ikrasmus/Bestaboard/README.md

"# Bestaboard" 

<h1>Heading</h1>

# Project Title
## Features
- Feature 1
- Feature 2
