ikrasmus/Bestaboard/BOM/BOM_PCB_Components.pdf

Reference | Qty | Value | DNP | Exclude from BOM | Exclude from Board | Footprint | Datasheet | Purchase Link | Cost Per | Cost Total
C1,C2,C3,C4,C5,C6,C7,C8 | 8 | 0.1uF | | | | Capacitor_SMD:C_0603_1608Metric_Pad1.08x0.95mm_HandSolder https://yageogroup.com/content/datasheet/asset/file/KEM_C1002_X7R_SMD https://www.digikey.com/en/products/detail/kemet/C0603C104K5RACTU/1465594 0.06 | | | | 0.48
C9,C10 | 2 | 1uF | | | | Capacitor_SMD:C_0603_1608Metric_Pad1.08x0.95mm_HandSolder https://yageogroup.com/content/datasheet/asset/file/KEM_C1002_X7R_SMD https://www.digikey.com/en/products/detail/kemet/C0603C105K4RACTU/2199788 0.05 | | | | 0.1
H1,H2,H3,H4 | 4 | MountingHole | | Excluded from BOM | | MountingHole:MountingHole_3.2mm_M3_ISO14580~ | | | 0 | 0
J1,J2 | 2 | S5B-XH-A | | | | Connector_JST:JST_XH_S5B-XH-A_1x05_P2.50mm_Horizontal https://www.jst-mfg.com/product/pdf/eng/eXH.pdf https://www.digikey.com/en/products/detail/jst-sales-america-inc/S5B-XH-A/1651040 0.22 | | | | 0.44
J3 | 1 | PPTC051LGBN-RC | | | | Connector_PinHeader_2.54mm:PinHeader_1x05_P2.54mm_Horizontal https://mm.digikey.com/Volume0/opasdata/d220001/medias/docus/937/Female_Headers.100_DS.pdf https://www.digikey.com/en/products/detail/sullins-connector-solutions/PPTC051LGBN-RC/775899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 0.54 | | | | 0.54
J4,J10 | 2 | XHP-5 | | Excluded from BOM | Excluded from board | | https://www.jst-mfg.com/product/pdf/eng/eXH.pdf https://www.digikey.com/en/products/detail/jst-sales-america-inc/XHP-5/1125486 0 | | | 0
J5 | 1 | PPTC061LGBN-RC | | | | Connector_PinHeader_2.54mm:PinHeader_1x06_P2.54mm_Horizontal https://mm.digikey.com/Volume0/opasdata/d220001/medias/docus/937/Female_Headers.100_DS.pdf https://www.digikey.com/en/products/detail/sullins-connector-solutions/PPTC061LGBN-RC/775900 0.54 | | | | 0.54
J6 | 1 | PRPC006SGAN-M71RC | | | | Connector_PinHeader_2.54mm:PinHeader_1x06_P2.54mm_Vertical https://mm.digikey.com/Volume0/opasdata/d220001/medias/docus/2610/x%20RxCxxxSxxN-M71RC_%2011637-B.pdf https://www.digikey.com/en/products/detail/sullins-connector-solutions/PRPC006SGAN-M71RC/2775448 0.4 | | | | 0.4
J7,J8 | 2 | S3B-XH-A | | | | Connector_JST:JST_XH_S3B-XH-A_1x03_P2.50mm_Horizontal https://www.jst-mfg.com/product/pdf/eng/eXH.pdf https://www.digikey.com/en/products/detail/jst-sales-america-inc/S3B-XH-A/1651048 0.15 | | | | 0.3
J9 | 1 | PRPC005SGAN-M71RC | | | | Connector_PinHeader_2.54mm:PinHeader_1x05_P2.54mm_Vertical https://mm.digikey.com/Volume0/opasdata/d220001/medias/docus/2610/x%20RxCxxxSxxN-M71RC_%2011637-B.pdf https://www.digikey.com/en/products/detail/sullins-connector-solutions/PRPC005SGAN-M71RC/2775449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 0.38 | | | | 0.38
J11,J12 | 2 | XHP-3 | | | Excluded from board | | https://www.jst-mfg.com/product/pdf/eng/eXH.pdf https://www.digikey.com/en/products/detail/jst-sales-america-inc/XHP-3/1651017 0.07 | | | 0.14
M1,M2 | 2 | 28BYJ-48 | | | Excluded from board | | http://www.infineon.com/dgdl/Application-Note-TLE8110EE_driving_UniPolarStepperMotor_V1.1.pdf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 https://www.amazon.com/s?k=28byj-48&crid=374TO9H7W8172&sprefix=28byj-48%2Caps%2C175&ref=nb_sb_noss_1 2.92 | | | 5.84
U1 | 1 | CD74HCT164E | | | | Package_DIP:DIP-14_W7.62mm_LongPads | https://www.ti.com/lit/ds/symlink/cd74hct164.pdf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 https://www.digikey.com/en/products/detail/texas-instruments/CD74HCT164E/38350 0.53 | | | 0.53
U2,U3 | 2 | CD4042BE | | | | Package_DIP:DIP-16_W7.62mm_LongPads | https://www.ti.com/lit/ds/symlink/cd4042b.pdf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 https://www.digikey.com/en/products/detail/texas-instruments/CD4042BE/67289 0.49 | | | 0.98
U4 | 1 | SN74HC00N | | | | Package_DIP:DIP-14_W7.62mm_LongPads | https://www.ti.com/lit/ds/symlink/sn74hc00.pdf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 https://www.digikey.com/en/products/detail/texas-instruments/SN74HC00N/277209 0.51 | | | 0.51
U5 | 1 | CD4081BE | | | | Package_DIP:DIP-14_W7.62mm_LongPads | https://www.ti.com/general/docs/suppproductinfo.tsp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 https://www.digikey.com/en/products/detail/texas-instruments/CD4081BE/67323 0.73 | | | 0.73
U6,U7 | 2 | DRV5032FALPGM | | | Excluded from board | Package_TO_SOT_THT:TO-92_Inline | https://www.ti.com/lit/ds/symlink/drv5032.pdf https://www.digikey.com/en/products/detail/texas-instruments/DRV5032FALPGM/12165125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 0.25 | | | 0.5
U8,U9 | 2 | ULN2003A | | Exclude from BOM | | Package_DIP:DIP-16_W7.62mm_LongPads | https://www.ti.com/lit/ds/symlink/uln2003a.pdf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 0 | | | 0
U10 | 1 | TC74HC04APF | | | | Package_DIP:DIP-14_W7.62mm_LongPads | https://mm.digikey.com/Volume0/opasdata/d220001/medias/docus/889/TC74HC04.pdf https://www.digikey.com/en/products/detail/toshiba-semiconductor-and-storage/TC74HC04APF/870457 0.18 | | | 0.18
| | | | | | | | | Total: | 12.59
