ikrasmus/Bestaboard/BOM/BOM_Print_Material.pdf

Plate | Material 1 (g) | Material 2 (g) | Time (m)
Drum - Main | 32.3 | 0 | 64
Drum - End | 10.3 | 0 | 30
Flips - 1 | 14.3 | 3.4 | 54
Flips - 2 | 14.3 | 3.4 | 55
Flips - 3 | 15.3 | 2.4 | 51
Frame - Main | 41.43 | 0 | 89
Frame - Holder (0.5) | 1.7 | 0 | 8
Frame - Connector (0.5) | 0.9 | 0 | 6
PCB - Spacer (0.5) | 0.4 | 0 | 4.5
PCB - Connector (0.5) | 0.6 | 0 | 5
Total | 131.53 | 9.2 | 366.5
Total Material: | 140.73
Bulk Material Cost (1kg): | 12.99
Total Cost: | $1.83
