ikrasmus/Bestaboard/Prints/Individual/Flips/Assembled - Asterisk - Char_Prev_Top-1.STL

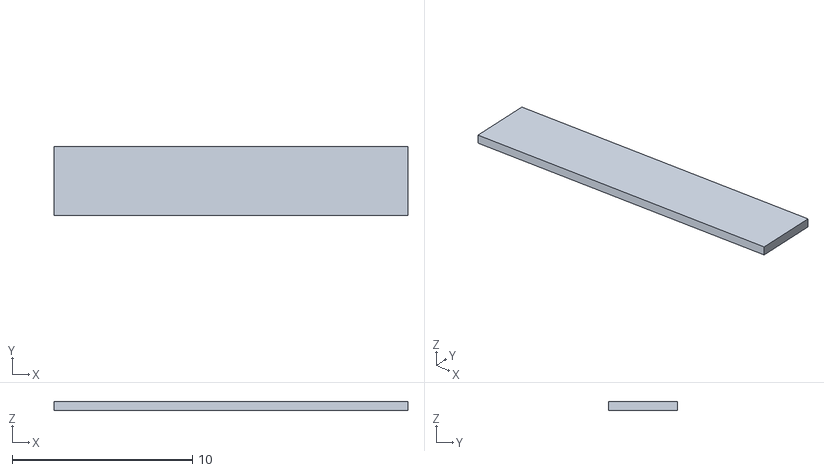
[picture p4: CAD file, 2026-02-08]
Prints/Individual/Flips/Assembled - Asterisk - Char_Prev_Top-1.STL
19.6 x 3.85 x 0.5
