ikrasmus/Bestaboard/Prints/Individual/Tools/Tool - Drum_Assembly.STL

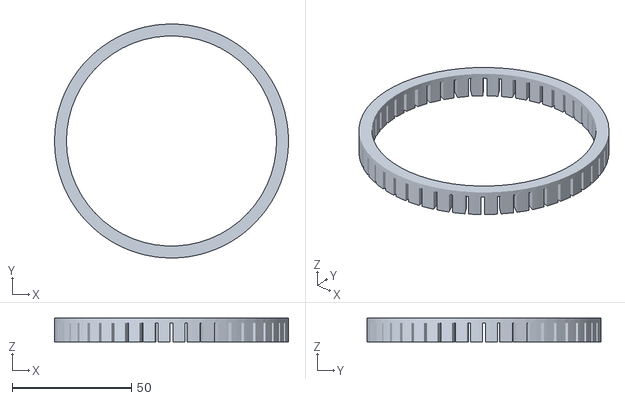
[picture p5: CAD file, 2026-04-19]
Prints/Individual/Tools/Tool - Drum_Assembly.STL
98.0 x 98.0 x 10.0
