ikrasmus/Bestaboard/Prints/Individual/Flips/Assembled - 5 - Body_Bottom-1.STL

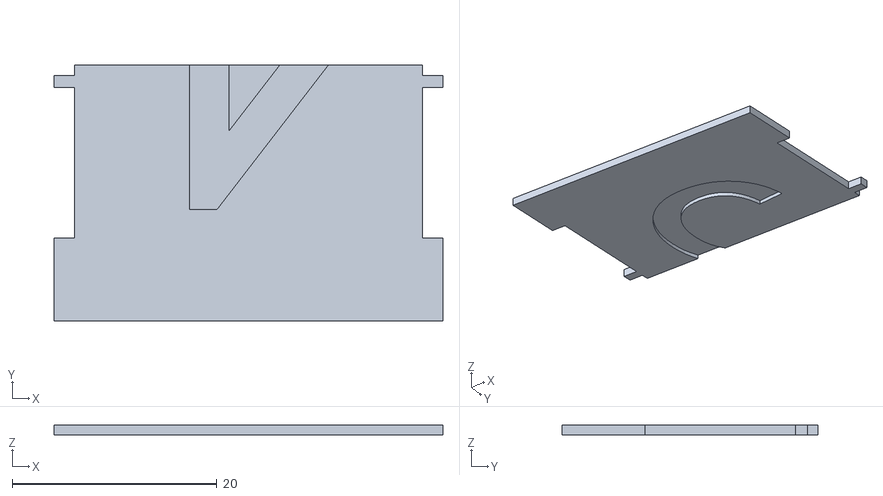
[picture p6: CAD file, 2026-02-08]
Prints/Individual/Flips/Assembled - 5 - Body_Bottom-1.STL
38.0 x 25.0 x 1.00
