ikrasmus/Bestaboard/Prints/Individual/Flips/Assembled - Question - Body_Bottom-1.STL

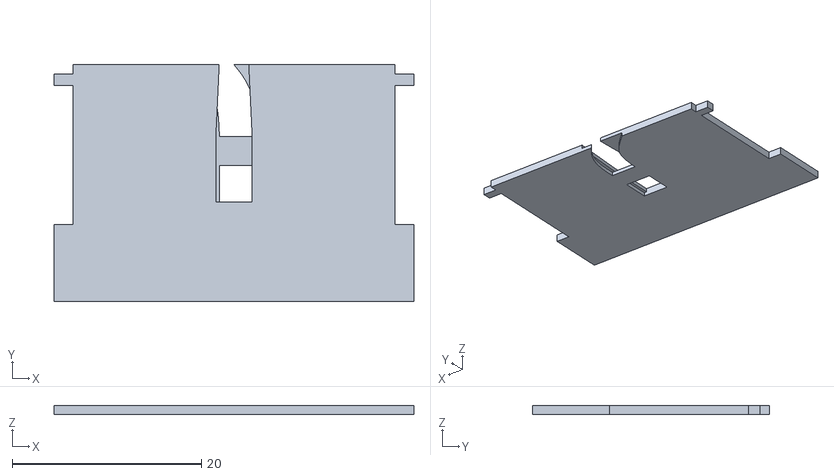
[picture p7: CAD file, 2026-02-08]
Prints/Individual/Flips/Assembled - Question - Body_Bottom-1.STL
38.0 x 25.0 x 1
