ikrasmus/Bestaboard/Prints/Individual/Flips/Assembled - Asterisk - Char_Top-1.STL

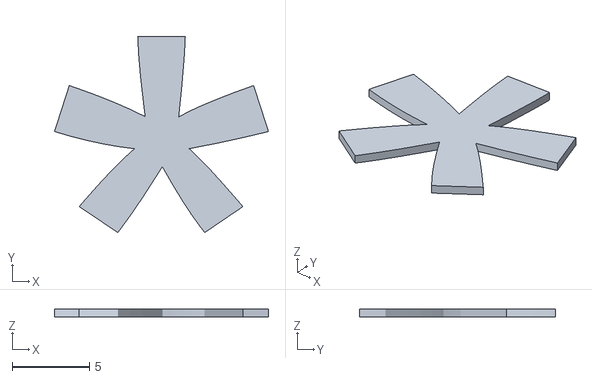
[picture p8: CAD file, 2026-02-08]
Prints/Individual/Flips/Assembled - Asterisk - Char_Top-1.STL
13.8 x 12.7 x 0.5
