ikrasmus/Bestaboard/Prints/Individual/Frame & Drum/Drum - Main.STL

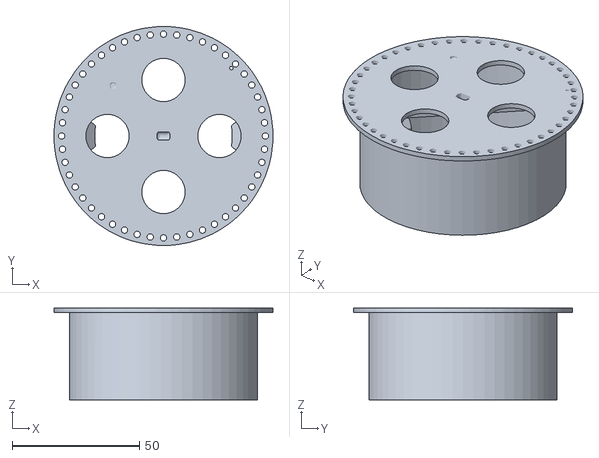
[picture p9: CAD file, 2026-04-25]
Prints/Individual/Frame & Drum/Drum - Main.STL
86.0 x 86.0 x 36.0
