ikrasmus/Bestaboard/Solidworks/Frame & Drum/Frame - Main.SLDPRT

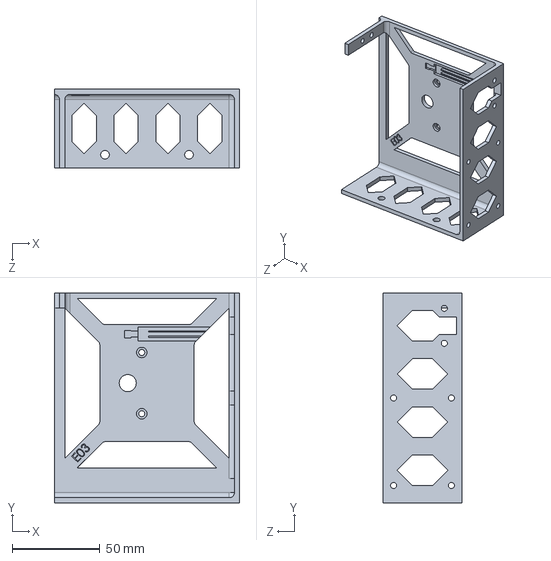
[picture p10: CAD file, 2026-04-25]
Solidworks/Frame & Drum/Frame - Main.SLDPRT
106.0 x 120.0 x 45.0 mm
