ikrasmus/Bestaboard/Prints/Individual/Flips/Assembled - Question - Char_Top-1.STL

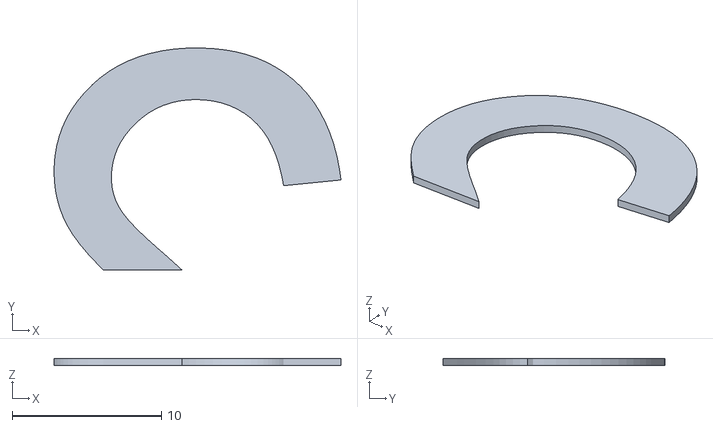
[picture p11: CAD file, 2026-02-08]
Prints/Individual/Flips/Assembled - Question - Char_Top-1.STL
19.2 x 14.9 x 0.5
