ikrasmus/Bestaboard/Prints/Individual/Flips/Assembled - Question - Char_Next_Bottom-1.STL

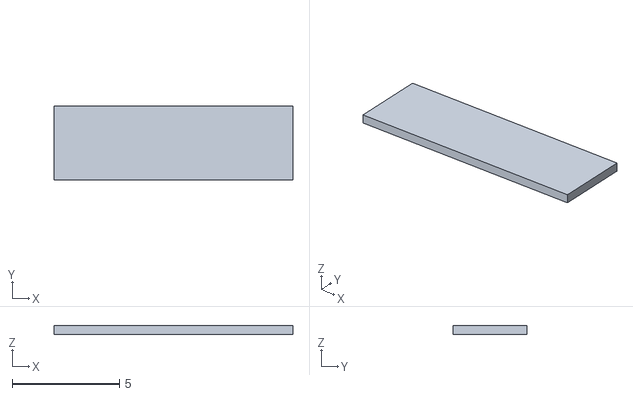
[picture p12: CAD file, 2026-02-08]
Prints/Individual/Flips/Assembled - Question - Char_Next_Bottom-1.STL
11.2 x 3.46 x 0.4
