ikrasmus/Bestaboard/Prints/Individual/Flips/Assembled - + - Char_Bottom-1.STL

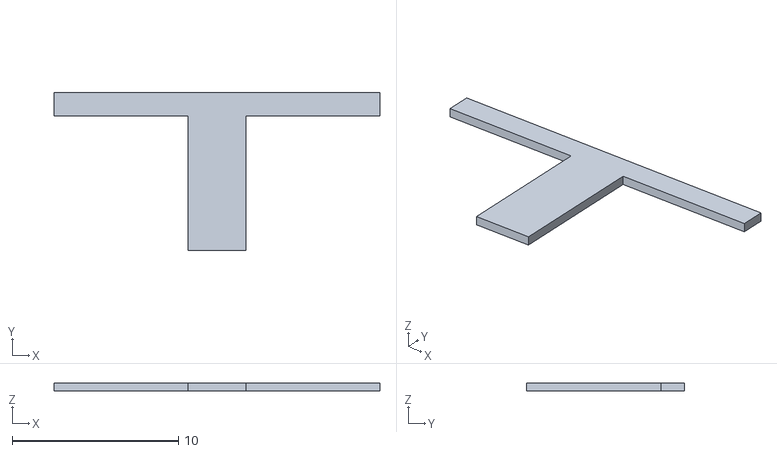
[picture p13: CAD file, 2026-02-08]
Prints/Individual/Flips/Assembled - + - Char_Bottom-1.STL
19.6 x 9.50 x 0.5
