ikrasmus/Bestaboard/Prints/Individual/Flips/Assembled - , - Prev_Extrude-1.STL

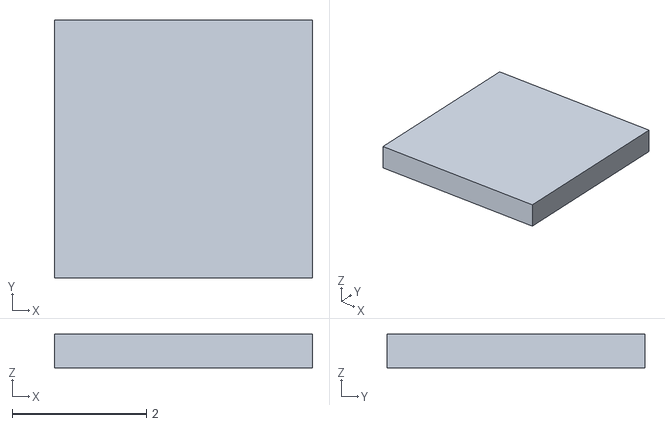
[picture p14: CAD file, 2026-02-08]
Prints/Individual/Flips/Assembled - , - Prev_Extrude-1.STL
3.85 x 3.85 x 0.5
