ikrasmus/Bestaboard/Prints/Individual/Flips/Assembled - Colon - Char_Prev_Top-1.STL

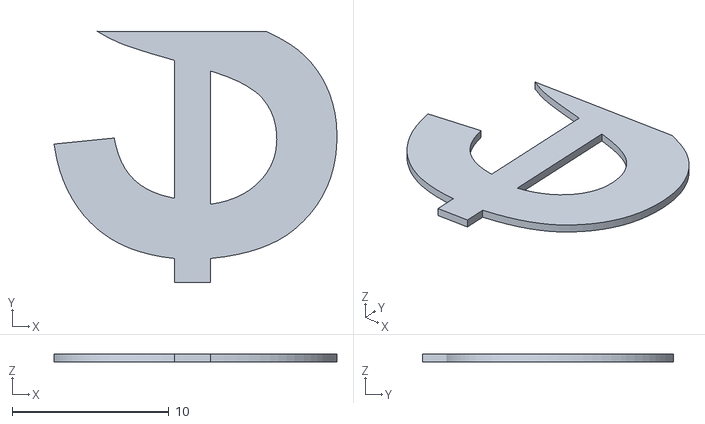
[picture p15: CAD file, 2026-02-08]
Prints/Individual/Flips/Assembled - Colon - Char_Prev_Top-1.STL
18.1 x 16.0 x 0.5
