ikrasmus/Bestaboard/Prints/Individual/Flips/Assembled - + - Char_Top-1.STL

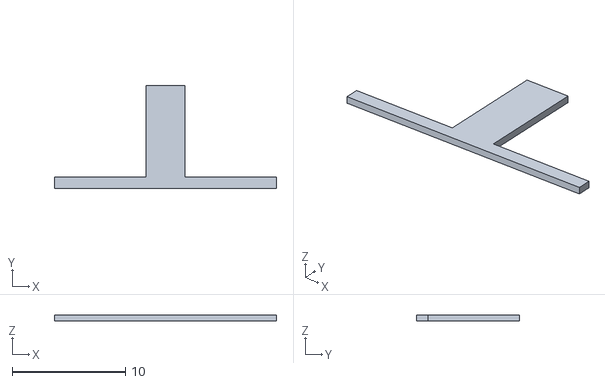
[picture p16: CAD file, 2026-02-08]
Prints/Individual/Flips/Assembled - + - Char_Top-1.STL
19.6 x 9.12 x 0.5
