ikrasmus/Bestaboard/Prints/Individual/Flips/Assembled - Home - Char_Next_Bottom-1.STL

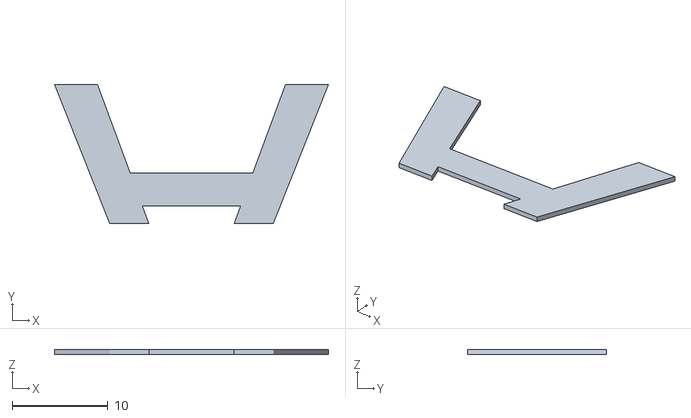
[picture p17: CAD file, 2026-02-08]
Prints/Individual/Flips/Assembled - Home - Char_Next_Bottom-1.STL
28.6 x 14.5 x 0.5
