ikrasmus/Bestaboard/Prints/Individual/Flips/Assembled - , - Front_Extrude-1.STL

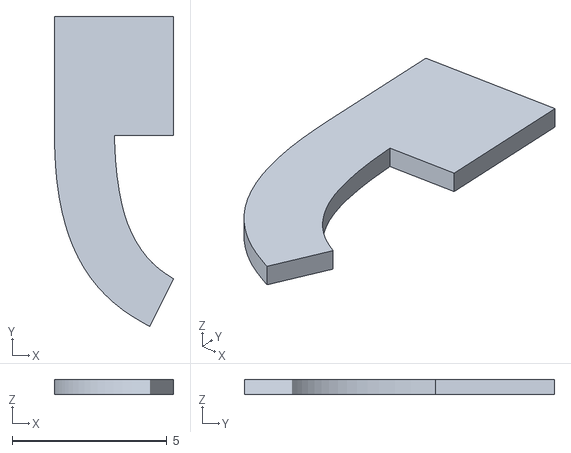
[picture p18: CAD file, 2026-02-08]
Prints/Individual/Flips/Assembled - , - Front_Extrude-1.STL
3.85 x 10.0 x 0.5
