ikrasmus/Bestaboard/Prints/Individual/Flips/Assembled - Asterisk - Char_Next_Bottom-1.STL

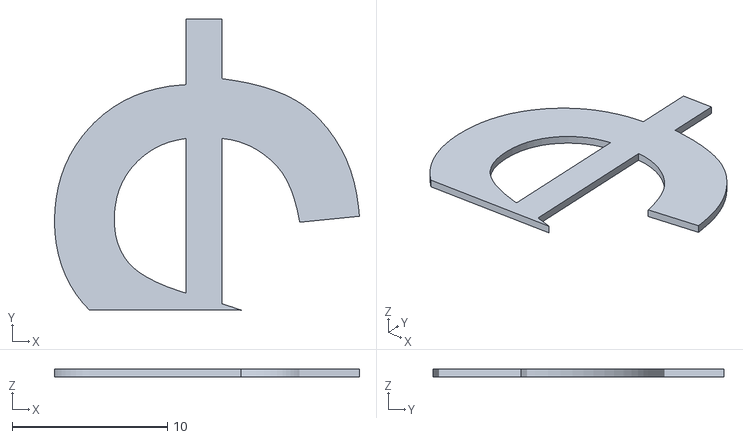
[picture p19: CAD file, 2026-02-08]
Prints/Individual/Flips/Assembled - Asterisk - Char_Next_Bottom-1.STL
19.6 x 18.7 x 0.5
