ikrasmus/Bestaboard/Prints/Individual/Flips/Assembled - , - Char_Next_Bottom-1.STL

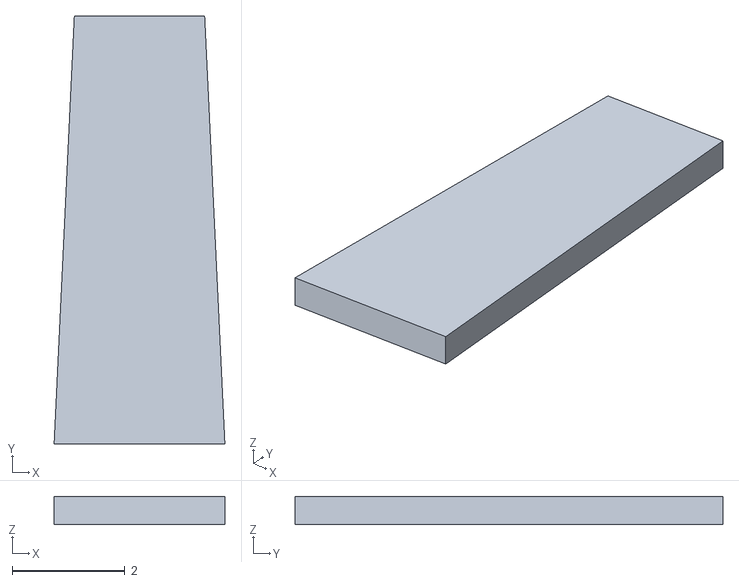
[picture p20: CAD file, 2026-02-08]
Prints/Individual/Flips/Assembled - , - Char_Next_Bottom-1.STL
3.02 x 7.58 x 0.5
