ikrasmus/Bestaboard/Prints/Individual/Flips/Assembled - Question - Char_Bottom_1-1.STL

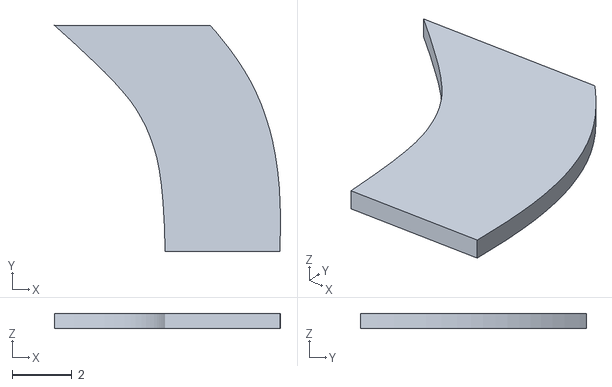
[picture p21: CAD file, 2026-02-08]
Prints/Individual/Flips/Assembled - Question - Char_Bottom_1-1.STL
7.57 x 7.58 x 0.5
