ikrasmus/Bestaboard/Prints/Individual/Flips/Assembled - Question - Char_Prev_Top-1.STL

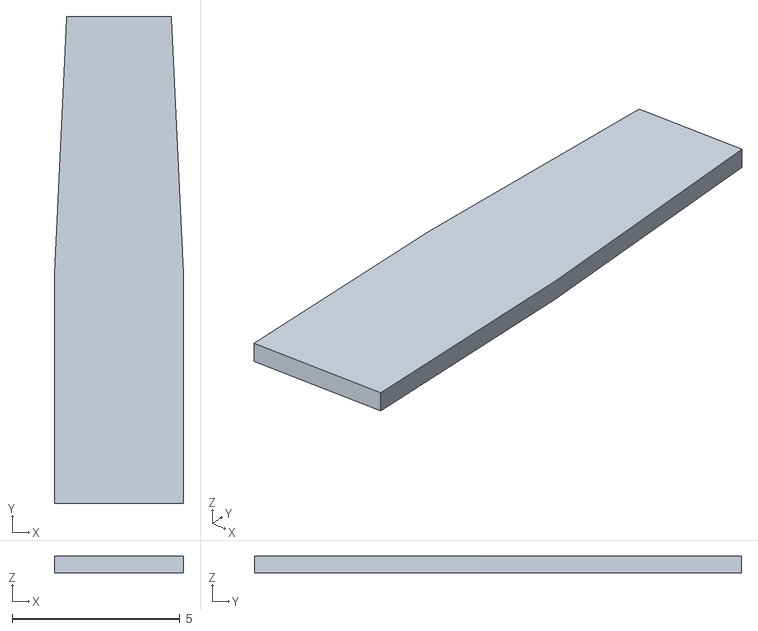
[picture p22: CAD file, 2026-02-08]
Prints/Individual/Flips/Assembled - Question - Char_Prev_Top-1.STL
3.85 x 14.5 x 0.5
