ikrasmus/Bestaboard/Prints/Individual/Flips/Assembled - 7 - Char_Top-2.STL

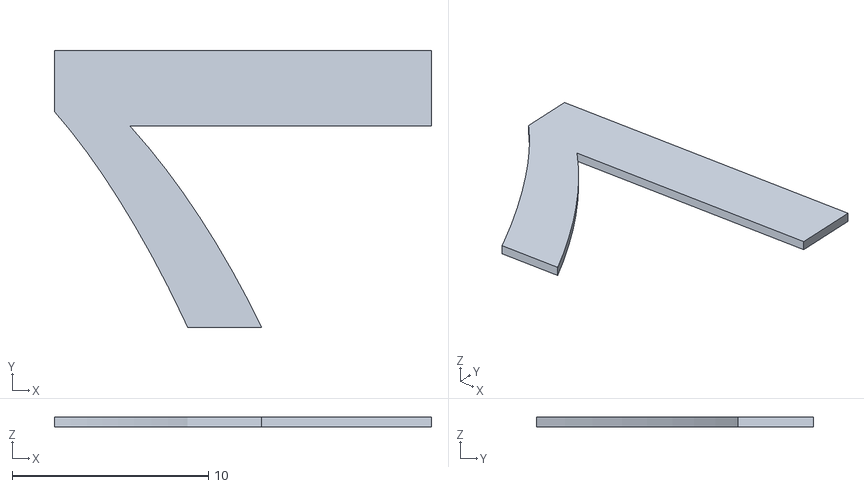
[picture p23: CAD file, 2026-02-08]
Prints/Individual/Flips/Assembled - 7 - Char_Top-2.STL
19.2 x 14.1 x 0.5
