ikrasmus/Bestaboard/Prints/Individual/Flips/Assembled - 9 - Char_Prev_Top-1.STL

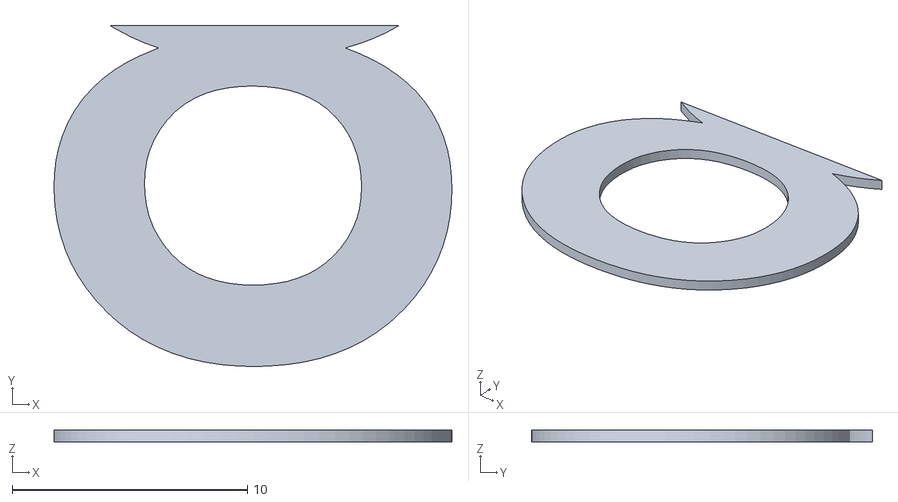
[picture p24: CAD file, 2026-01-27]
Prints/Individual/Flips/Assembled - 9 - Char_Prev_Top-1.STL
16.9 x 14.5 x 0.5
