ikrasmus/Bestaboard/Prints/Individual/Flips/Assembled - 5 - Char_Prev_Top-1.STL

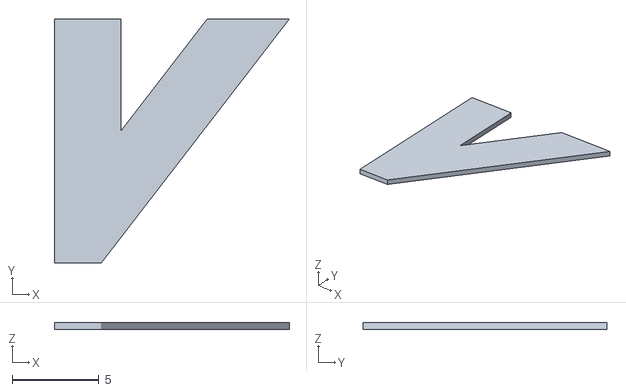
[picture p25: CAD file, 2026-01-27]
Prints/Individual/Flips/Assembled - 5 - Char_Prev_Top-1.STL
13.6 x 14.1 x 0.4
