ikrasmus/Bestaboard/Prints/Individual/Flips/Assembled - 7 - Char_Bottom-1.STL

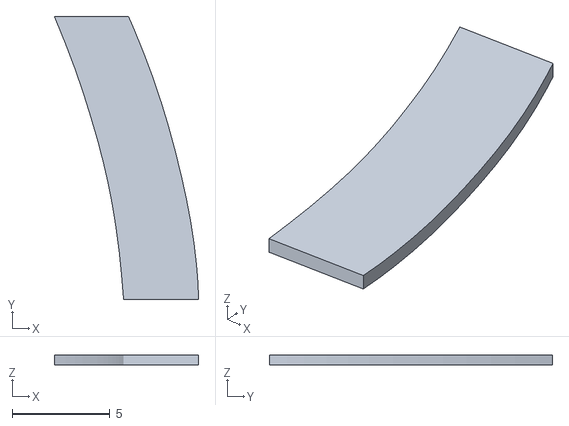
[picture p26: CAD file, 2026-01-27]
Prints/Individual/Flips/Assembled - 7 - Char_Bottom-1.STL
7.39 x 14.5 x 0.5
