ikrasmus/Bestaboard/Prints/Individual/Flips/Assembled - 9 - Char_Bottom-1.STL

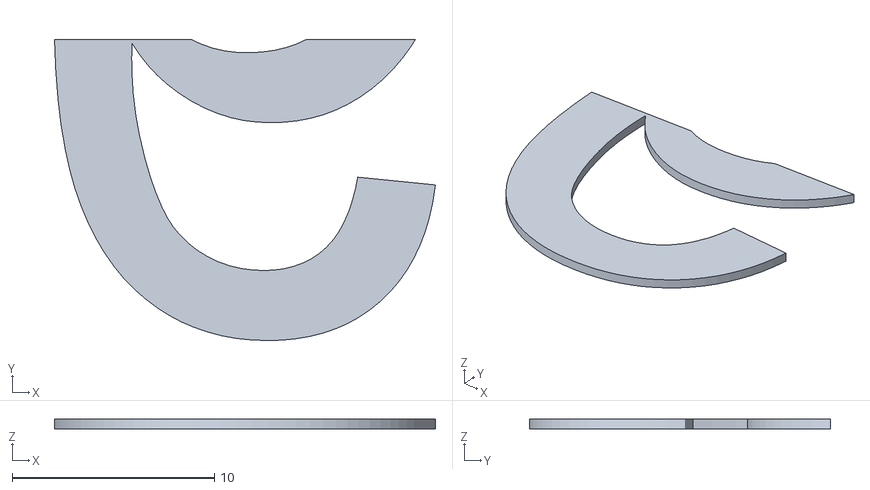
[picture p27: CAD file, 2026-01-27]
Prints/Individual/Flips/Assembled - 9 - Char_Bottom-1.STL
18.8 x 14.9 x 0.5
