ikrasmus/Bestaboard/Prints/Individual/Flips/Assembled - 1 - Char_Bottom-1.STL

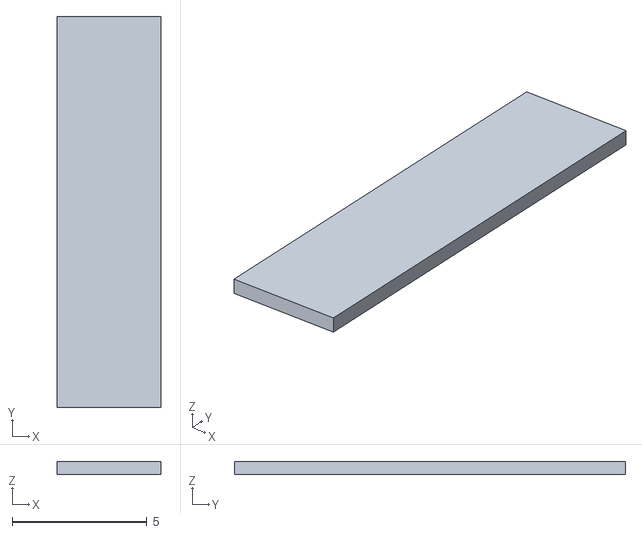
[picture p28: CAD file, 2026-01-27]
Prints/Individual/Flips/Assembled - 1 - Char_Bottom-1.STL
3.85 x 14.5 x 0.5
