ikrasmus/Bestaboard/Prints/Individual/Flips/Assembled - 1 - Char_Next_Bottom-1.STL

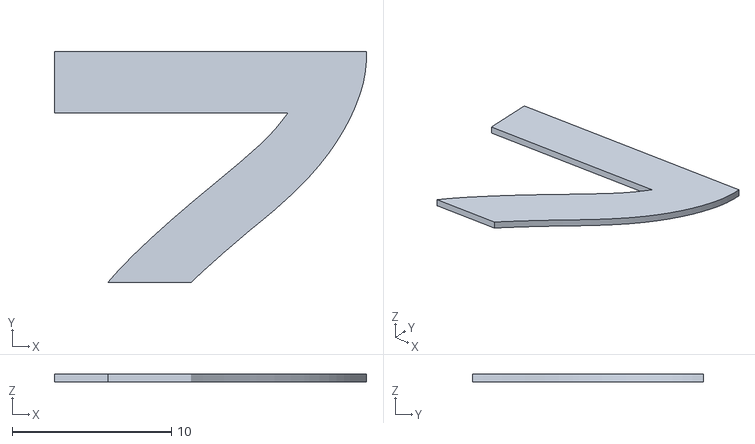
[picture p29: CAD file, 2026-01-27]
Prints/Individual/Flips/Assembled - 1 - Char_Next_Bottom-1.STL
19.6 x 14.5 x 0.5
