ikrasmus/Bestaboard/Prints/Individual/Flips/Assembled - 5 - Char_Bottom-1.STL

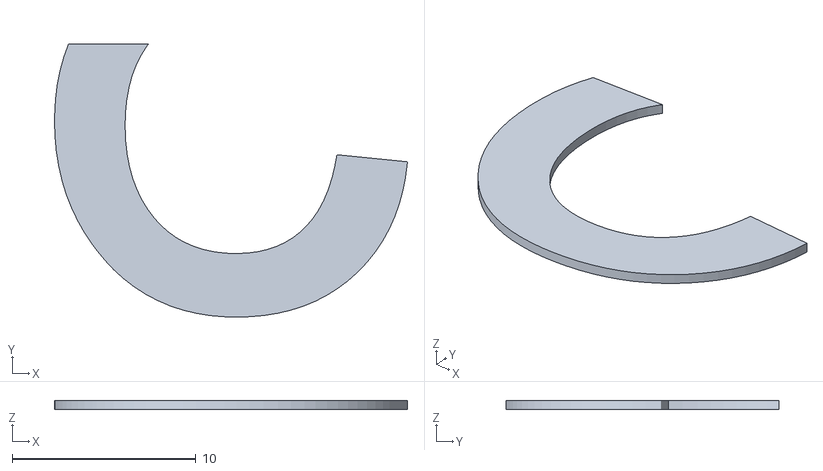
[picture p30: CAD file, 2026-01-27]
Prints/Individual/Flips/Assembled - 5 - Char_Bottom-1.STL
19.2 x 14.9 x 0.5
