ikrasmus/Bestaboard/Prints/Individual/Flips/Assembled - Z - Char_Top-1.STL

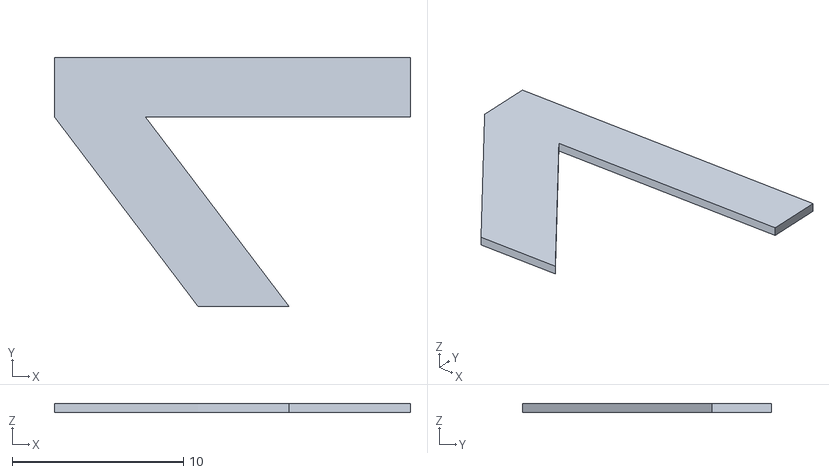
[picture p31: CAD file, 2026-01-27]
Prints/Individual/Flips/Assembled - Z - Char_Top-1.STL
20.8 x 14.5 x 0.5
