ikrasmus/Bestaboard/Prints/Individual/Flips/Assembled - 3 - Body_Bottom-1.STL

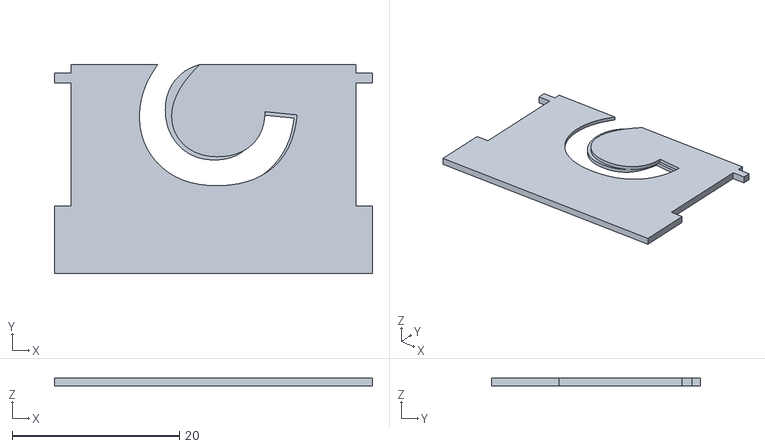
[picture p33: CAD file, 2026-01-27]
Prints/Individual/Flips/Assembled - 3 - Body_Bottom-1.STL
38.0 x 25.0 x 1.00
