ikrasmus/Bestaboard/Prints/Individual/Flips/Assembled - 9 - Body_Bottom_2-1.STL

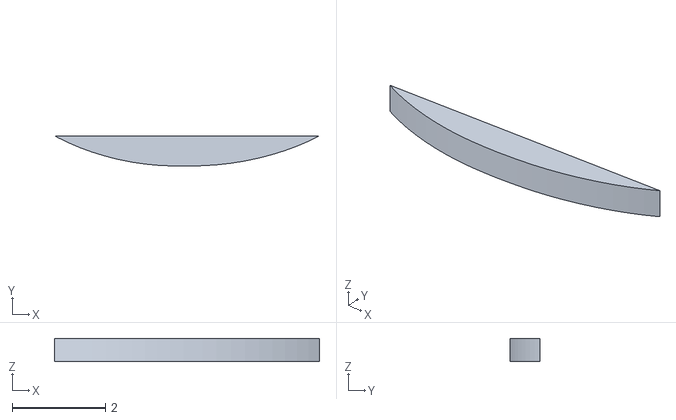
[picture p35: CAD file, 2026-01-27]
Prints/Individual/Flips/Assembled - 9 - Body_Bottom_2-1.STL
5.70 x 0.654 x 0.5
