ikrasmus/Bestaboard/Prints/Individual/Flips/Assembled - 7 - Char_Prev_Top-1.STL

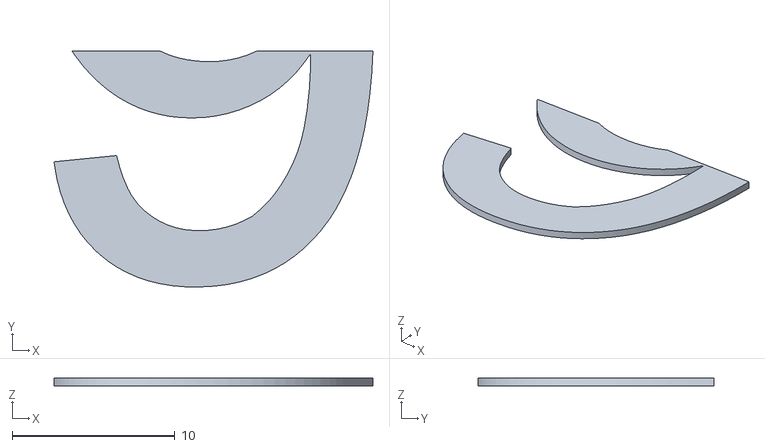
[picture p36: CAD file, 2026-01-27]
Prints/Individual/Flips/Assembled - 7 - Char_Prev_Top-1.STL
19.6 x 14.5 x 0.5
