ikrasmus/Bestaboard/Prints/Individual/Flips/Assembled - Z - Char_Prev_Top-1.STL

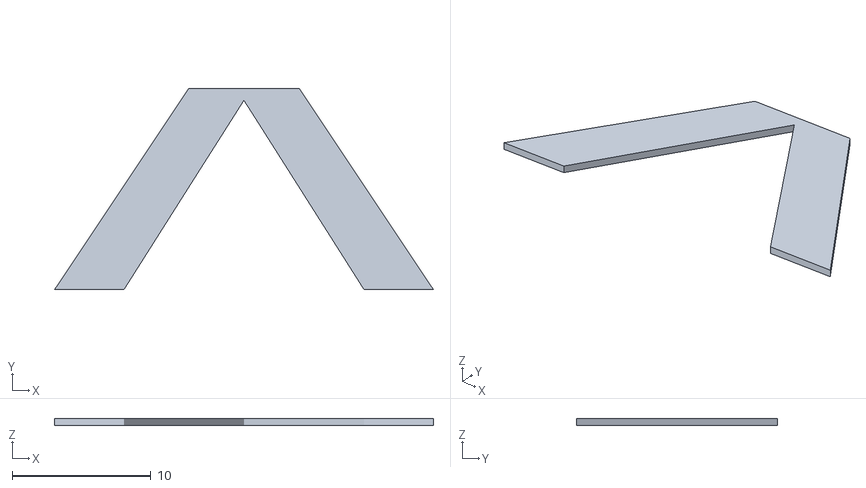
[picture p38: CAD file, 2026-01-27]
Prints/Individual/Flips/Assembled - Z - Char_Prev_Top-1.STL
27.3 x 14.5 x 0.5
