ikrasmus/Bestaboard/Prints/Individual/Flips/Assembled - 5 - Char_Next_Bottom-1.STL

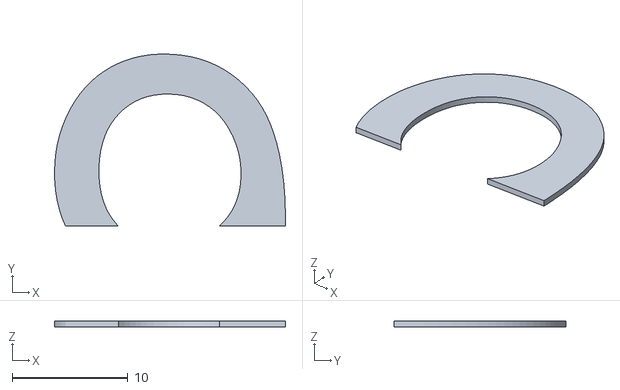
[picture p39: CAD file, 2026-01-27]
Prints/Individual/Flips/Assembled - 5 - Char_Next_Bottom-1.STL
20.0 x 14.9 x 0.5
