ikrasmus/Bestaboard/Prints/Individual/Flips/Assembled - 3 - Char_Top-1.STL

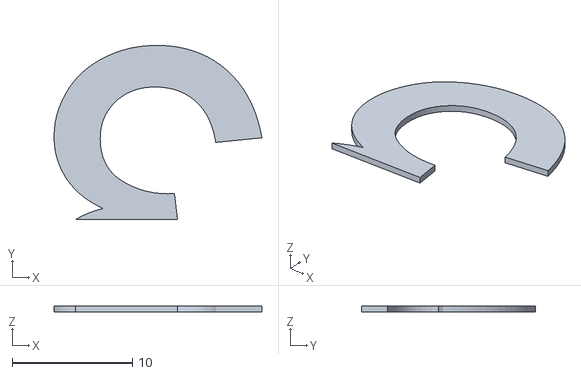
[picture p40: CAD file, 2026-01-27]
Prints/Individual/Flips/Assembled - 3 - Char_Top-1.STL
17.3 x 14.5 x 0.5
