ikrasmus/Bestaboard/Prints/Individual/Flips/Assembled - 9 - Char_Top-1.STL

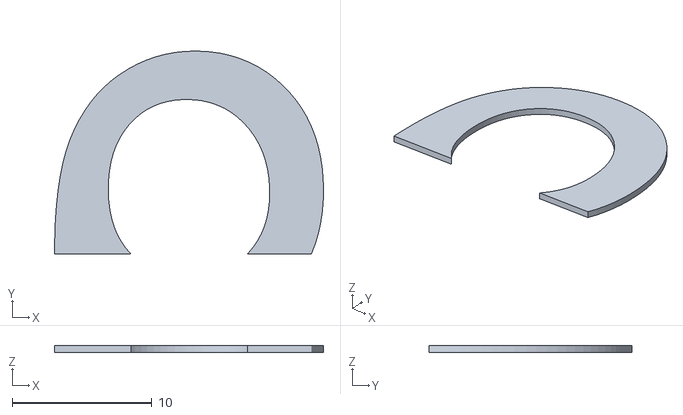
[picture p41: CAD file, 2026-01-27]
Prints/Individual/Flips/Assembled - 9 - Char_Top-1.STL
19.2 x 14.5 x 0.5
