ikrasmus/Bestaboard/Prints/Individual/Flips/Assembled - 3 - Char_Next_Top-1.STL

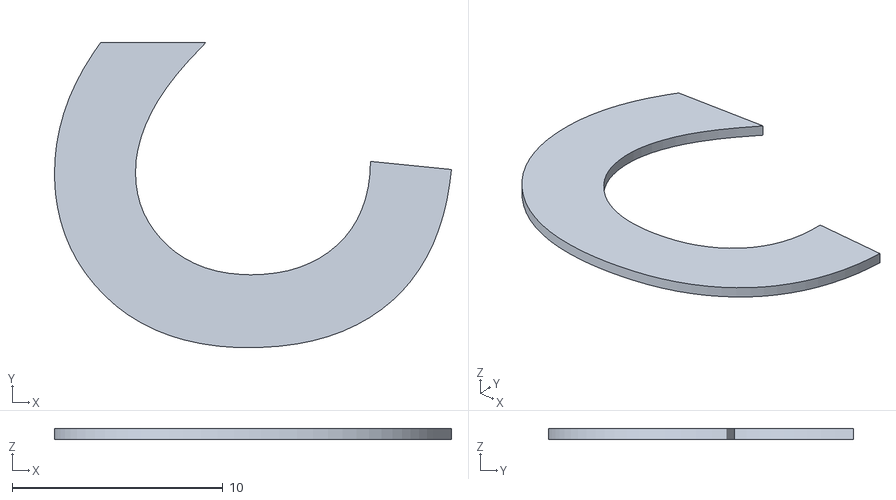
[picture p42: CAD file, 2026-01-27]
Prints/Individual/Flips/Assembled - 3 - Char_Next_Top-1.STL
18.8 x 14.5 x 0.5
