ikrasmus/Bestaboard/Prints/Individual/Flips/Assembled - Z - Char_Bottom-1.STL

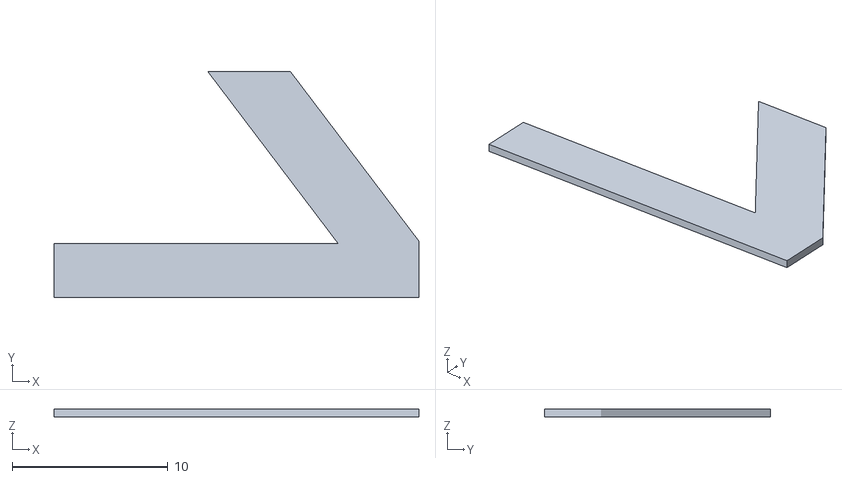
[picture p43: CAD file, 2026-01-27]
Prints/Individual/Flips/Assembled - Z - Char_Bottom-1.STL
23.5 x 14.5 x 0.5
