ikrasmus/Bestaboard/Prints/Individual/Flips/Assembled - 1 - Char_Top-1.STL

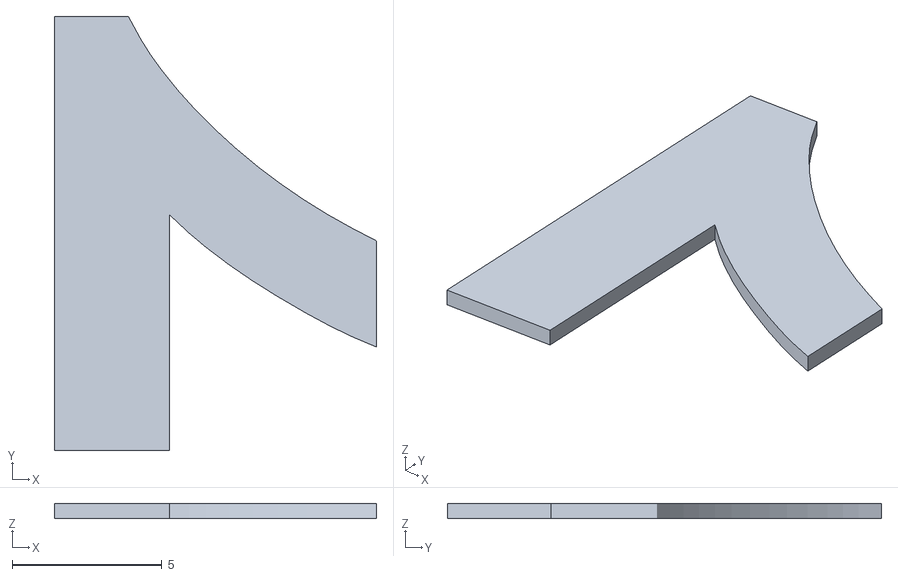
[picture p44: CAD file, 2026-01-27]
Prints/Individual/Flips/Assembled - 1 - Char_Top-1.STL
10.8 x 14.5 x 0.5
