ikrasmus/Bestaboard/Prints/Individual/Flips/Assembled - 3 - Char_Prev_Bottom-1.STL

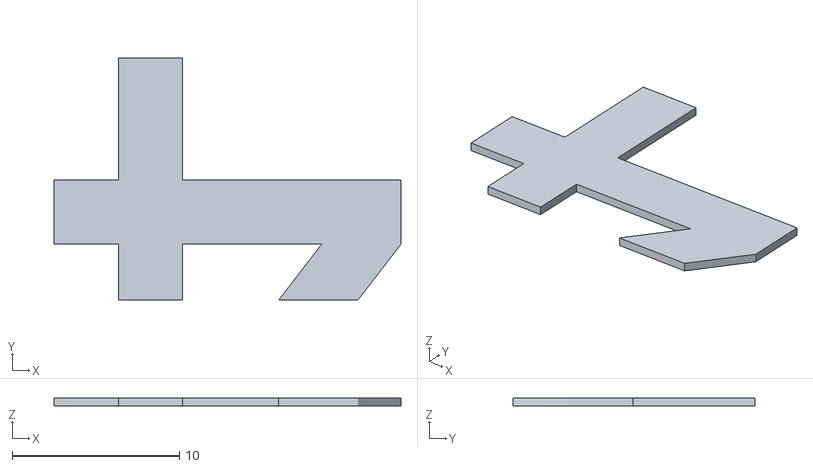
[picture p45: CAD file, 2026-01-27]
Prints/Individual/Flips/Assembled - 3 - Char_Prev_Bottom-1.STL
20.8 x 14.5 x 0.5
