ikrasmus/Bestaboard/Prints/Individual/Flips/Assembled - B - Char_Prev_Top-1.STL

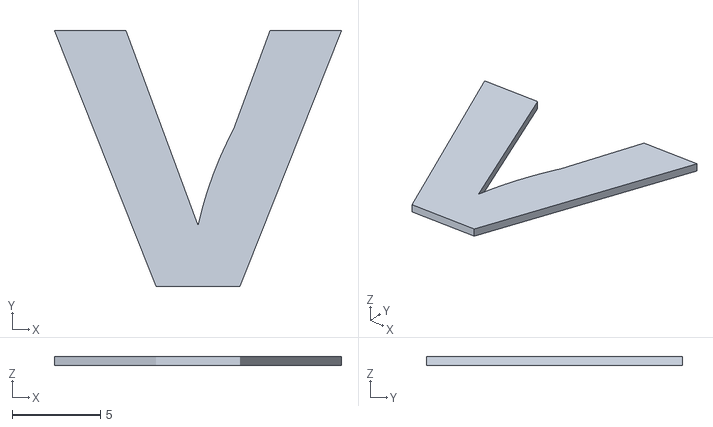
[picture p46: CAD file, 2026-01-24]
Prints/Individual/Flips/Assembled - B - Char_Prev_Top-1.STL
16.3 x 14.5 x 0.5
