ikrasmus/Bestaboard/Prints/Individual/Flips/Assembled - J - Char_Prev_Top-1.STL

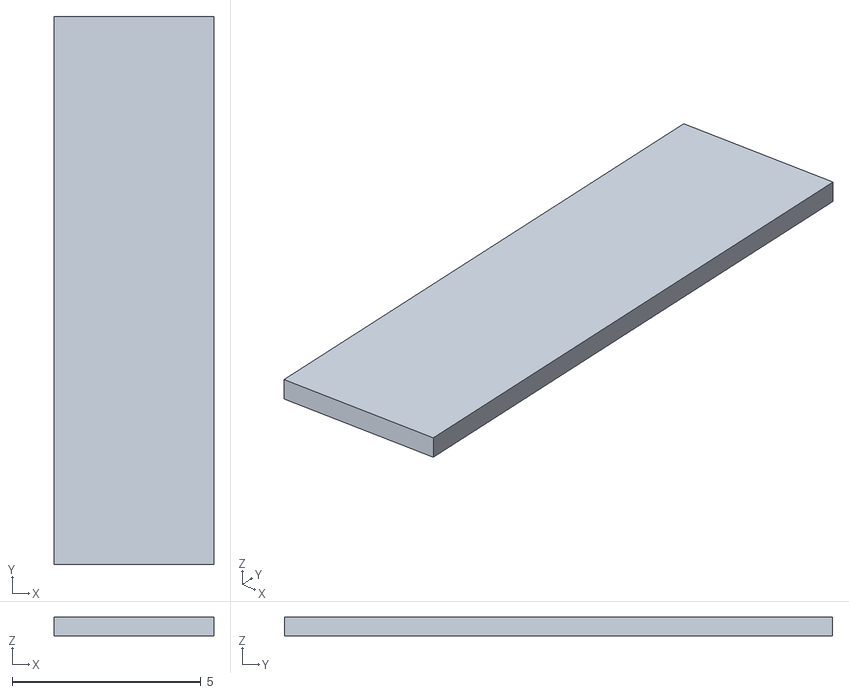
[picture p47: CAD file, 2026-01-24]
Prints/Individual/Flips/Assembled - J - Char_Prev_Top-1.STL
4.23 x 14.5 x 0.5
