ikrasmus/Bestaboard/Prints/Individual/Flips/Assembled - T - Char_Next_Bottom-1.STL

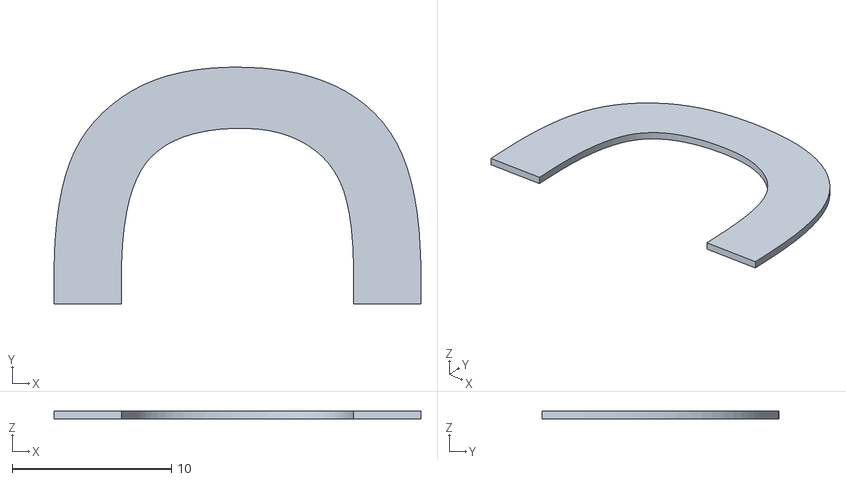
[picture p48: CAD file, 2026-01-24]
Prints/Individual/Flips/Assembled - T - Char_Next_Bottom-1.STL
23.1 x 14.9 x 0.5
