ikrasmus/Bestaboard/Prints/Individual/Flips/Assembled - H - Char_Prev_Top-1.STL

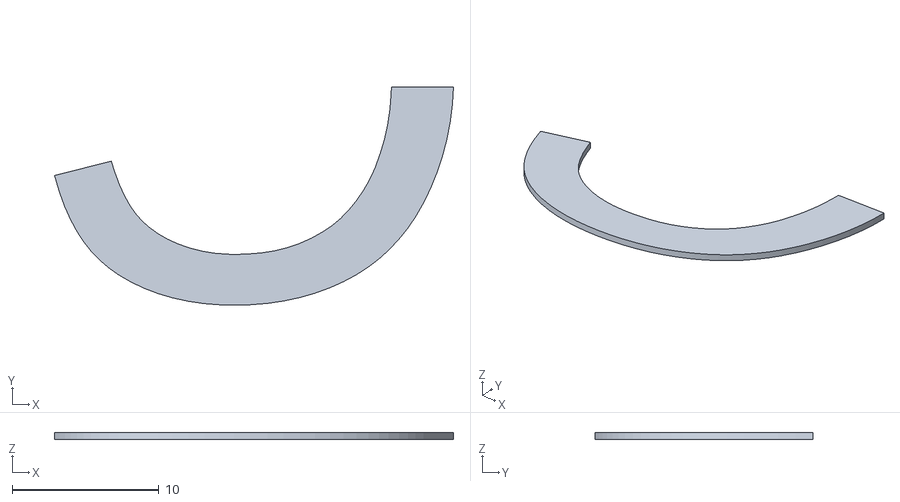
[picture p49: CAD file, 2026-01-24]
Prints/Individual/Flips/Assembled - H - Char_Prev_Top-1.STL
27.2 x 14.9 x 0.5
