ikrasmus/Bestaboard/Prints/Individual/Flips/Assembled - X - Char_Next_Bottom-1.STL

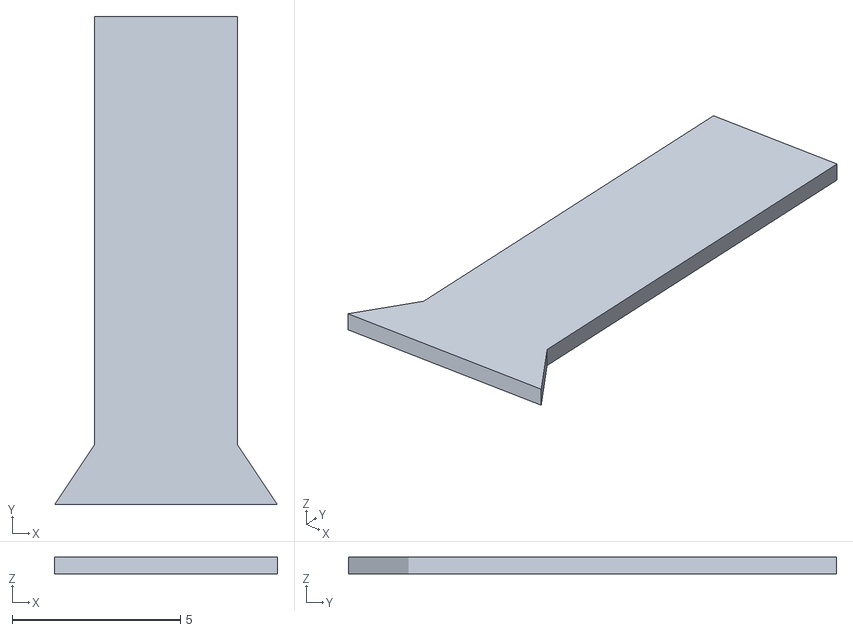
[picture p50: CAD file, 2026-01-24]
Prints/Individual/Flips/Assembled - X - Char_Next_Bottom-1.STL
6.62 x 14.5 x 0.5
