ikrasmus/Bestaboard/Prints/Individual/Flips/Assembled - P - Char_Bot-1.STL

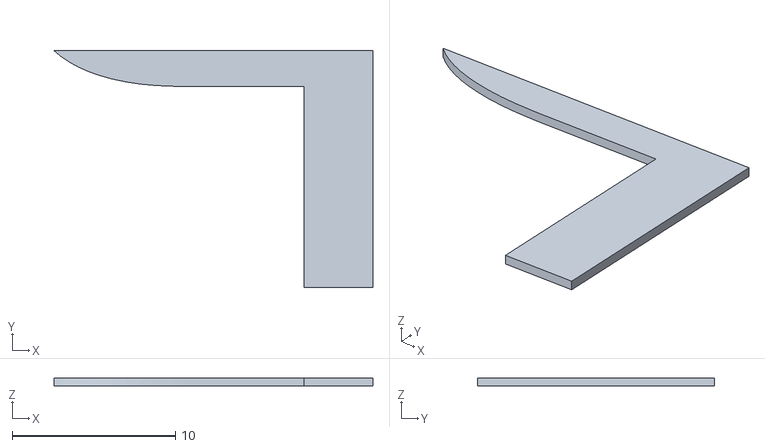
[picture p51: CAD file, 2026-01-24]
Prints/Individual/Flips/Assembled - P - Char_Bot-1.STL
19.5 x 14.5 x 0.5
