ikrasmus/Bestaboard/Prints/Individual/Flips/Assembled - L - Char_Prev_Top-1.STL

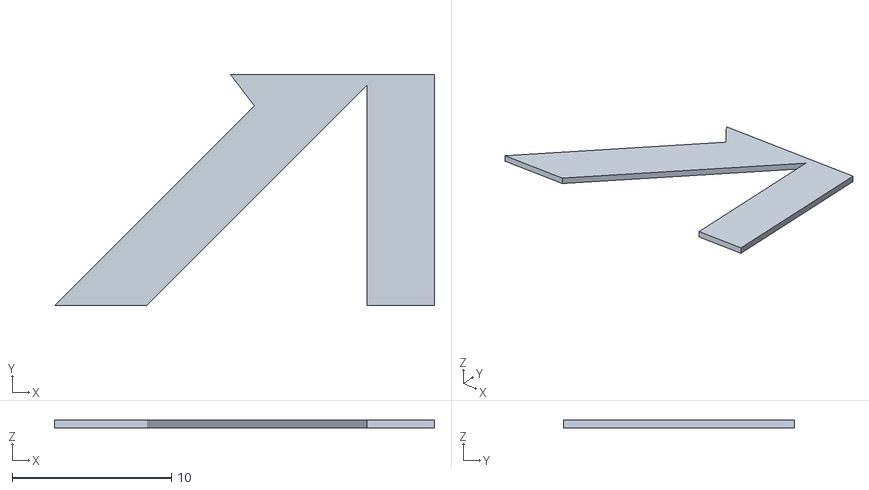
[picture p52: CAD file, 2026-01-24]
Prints/Individual/Flips/Assembled - L - Char_Prev_Top-1.STL
23.8 x 14.5 x 0.5
