ikrasmus/Bestaboard/Prints/Individual/Flips/Assembled - P - Char_Next_Bot-1.STL

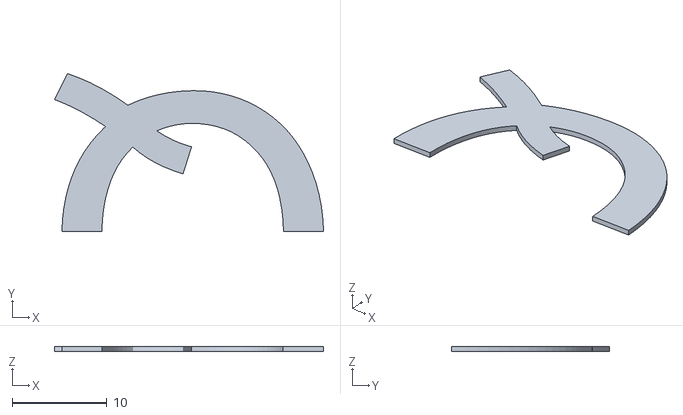
[picture p54: CAD file, 2026-01-24]
Prints/Individual/Flips/Assembled - P - Char_Next_Bot-1.STL
28.5 x 16.7 x 0.5
