ikrasmus/Bestaboard/Prints/Individual/Flips/Assembled - B - Char_Next_Bottom-1.STL

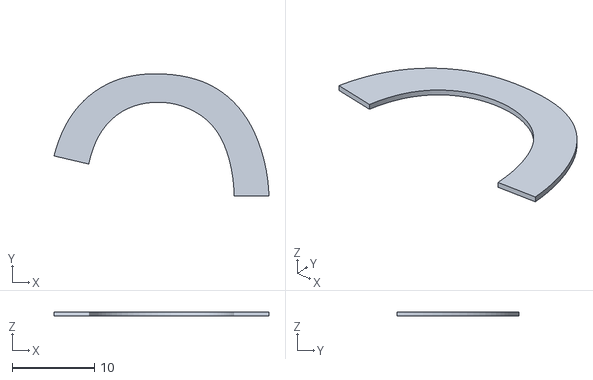
[picture p55: CAD file, 2026-01-24]
Prints/Individual/Flips/Assembled - B - Char_Next_Bottom-1.STL
26.1 x 14.9 x 0.5
