ikrasmus/Bestaboard/Prints/Individual/Flips/Assembled - J - Char_Bottom-1.STL

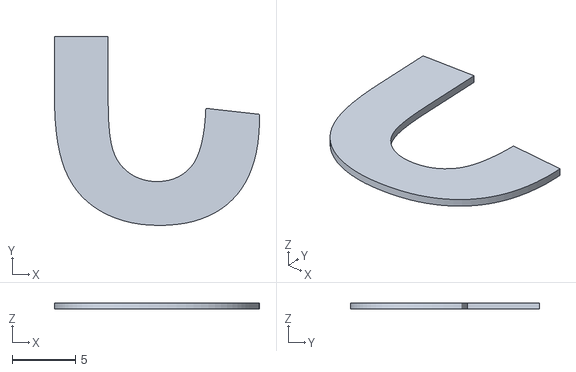
[picture p56: CAD file, 2026-01-24]
Prints/Individual/Flips/Assembled - J - Char_Bottom-1.STL
16.2 x 14.9 x 0.5
