ikrasmus/Bestaboard/Prints/Individual/Flips/Assembled - N - Char_Next_Bot-1.STL

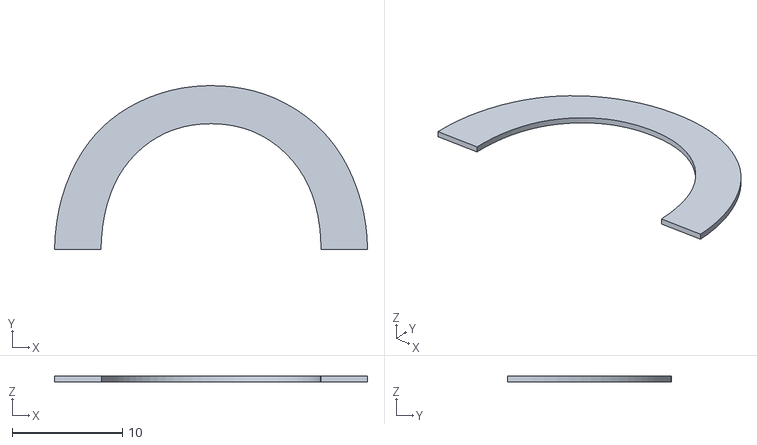
[picture p57: CAD file, 2026-01-24]
Prints/Individual/Flips/Assembled - N - Char_Next_Bot-1.STL
28.5 x 14.9 x 0.5
