ikrasmus/Bestaboard/Prints/Individual/Flips/Assembled - P - Char_Top-1.STL

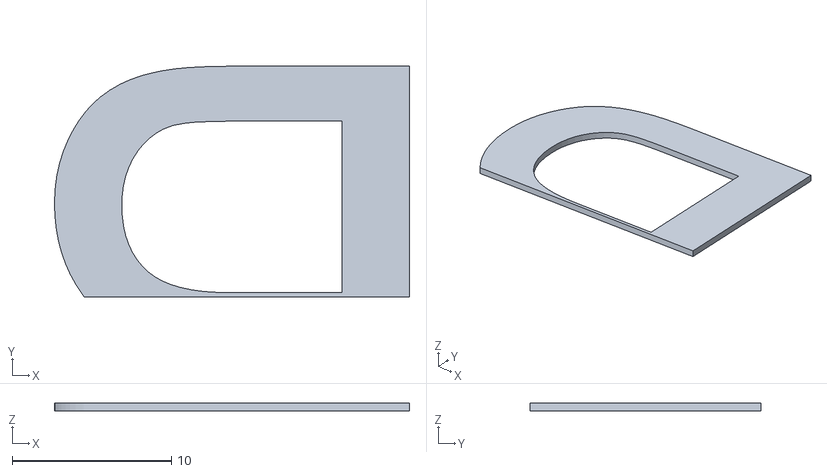
[picture p58: CAD file, 2026-01-24]
Prints/Individual/Flips/Assembled - P - Char_Top-1.STL
22.3 x 14.5 x 0.5
