ikrasmus/Bestaboard/Prints/Individual/Flips/Assembled - N - Char_Top_1-1.STL

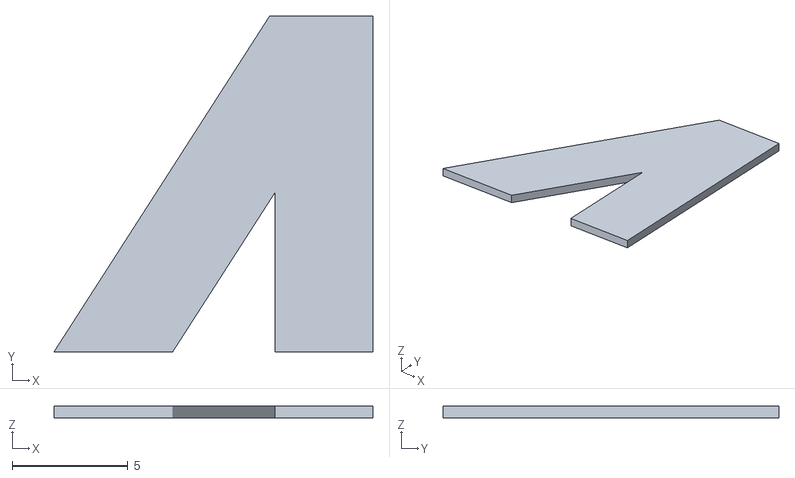
[picture p60: CAD file, 2026-01-24]
Prints/Individual/Flips/Assembled - N - Char_Top_1-1.STL
13.8 x 14.5 x 0.5
