ikrasmus/Bestaboard/Prints/Individual/Flips/Assembled - T - Char_Top-1.STL

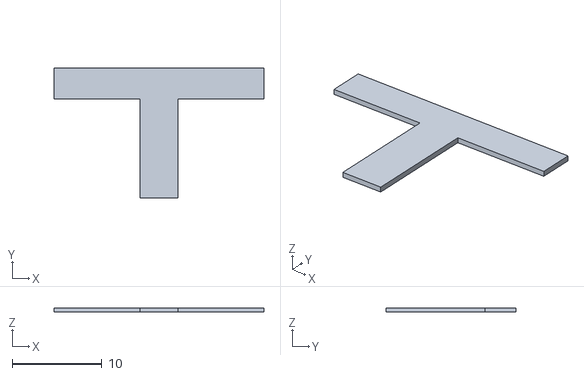
[picture p61: CAD file, 2026-01-24]
Prints/Individual/Flips/Assembled - T - Char_Top-1.STL
23.5 x 14.5 x 0.5
