ikrasmus/Bestaboard/Prints/Individual/Flips/Assembled - L - Char_Bot-1.STL

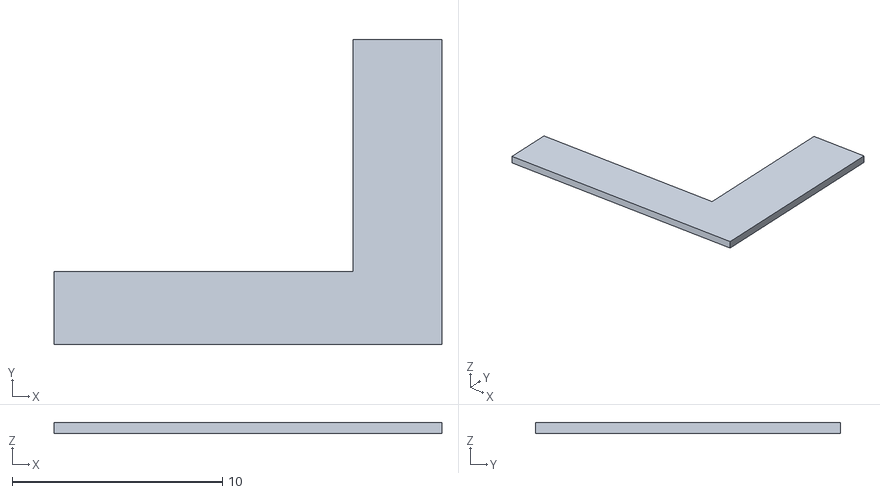
[picture p62: CAD file, 2026-01-24]
Prints/Individual/Flips/Assembled - L - Char_Bot-1.STL
18.5 x 14.5 x 0.5
