ikrasmus/Bestaboard/Prints/Individual/Flips/Assembled - D - Char_Next_Bottom-1.STL

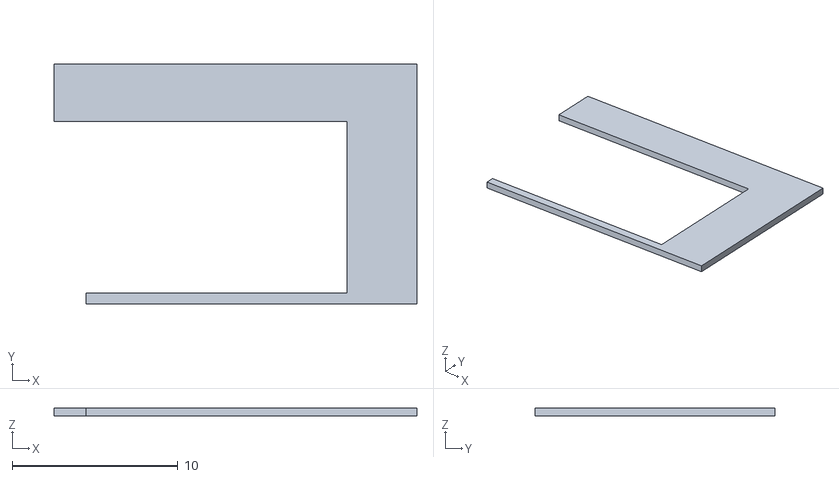
[picture p63: CAD file, 2026-01-24]
Prints/Individual/Flips/Assembled - D - Char_Next_Bottom-1.STL
21.9 x 14.5 x 0.5
