ikrasmus/Bestaboard/Prints/Individual/Flips/Assembled - V - Char_Top_2-1.STL

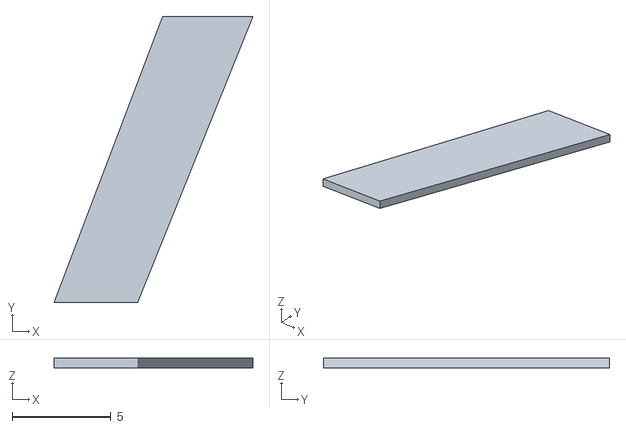
[picture p64: CAD file, 2026-01-24]
Prints/Individual/Flips/Assembled - V - Char_Top_2-1.STL
10.1 x 14.5 x 0.5
