ikrasmus/Bestaboard/Prints/Individual/Flips/Assembled - F - Char_Top-1.STL

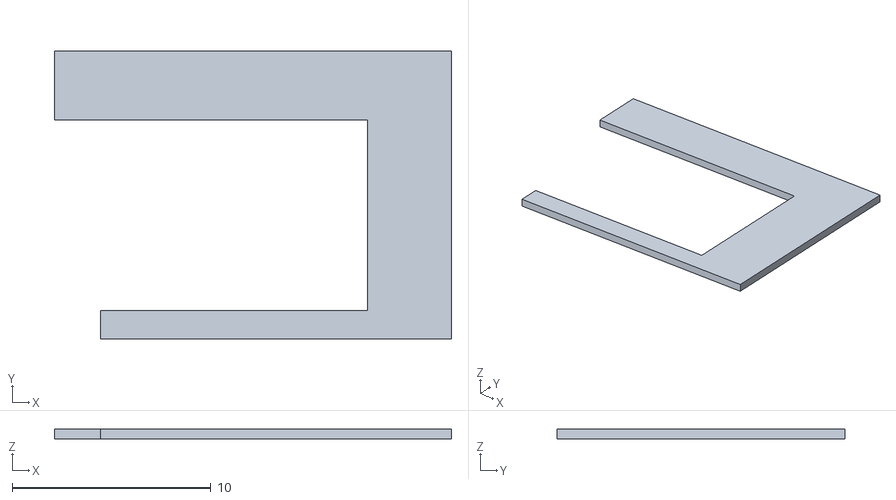
[picture p65: CAD file, 2026-01-24]
Prints/Individual/Flips/Assembled - F - Char_Top-1.STL
20.0 x 14.5 x 0.5
