ikrasmus/Bestaboard/Prints/Individual/Flips/Assembled - V - Char_Prev_Bot_2-1.STL

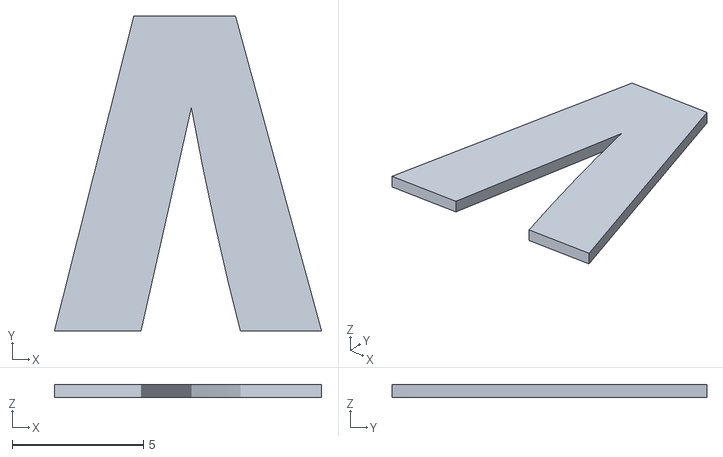
[picture p66: CAD file, 2026-01-24]
Prints/Individual/Flips/Assembled - V - Char_Prev_Bot_2-1.STL
10.2 x 12.0 x 0.5
