ikrasmus/Bestaboard/Prints/Individual/Flips/Assembled - X - Char_Top-1.STL

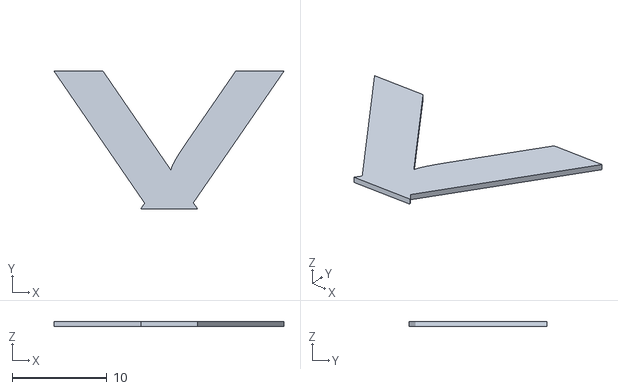
[picture p67: CAD file, 2026-01-24]
Prints/Individual/Flips/Assembled - X - Char_Top-1.STL
24.2 x 14.5 x 0.5
