ikrasmus/Bestaboard/Prints/Individual/Flips/Assembled - X - Char_Prev_Top_3-1.STL

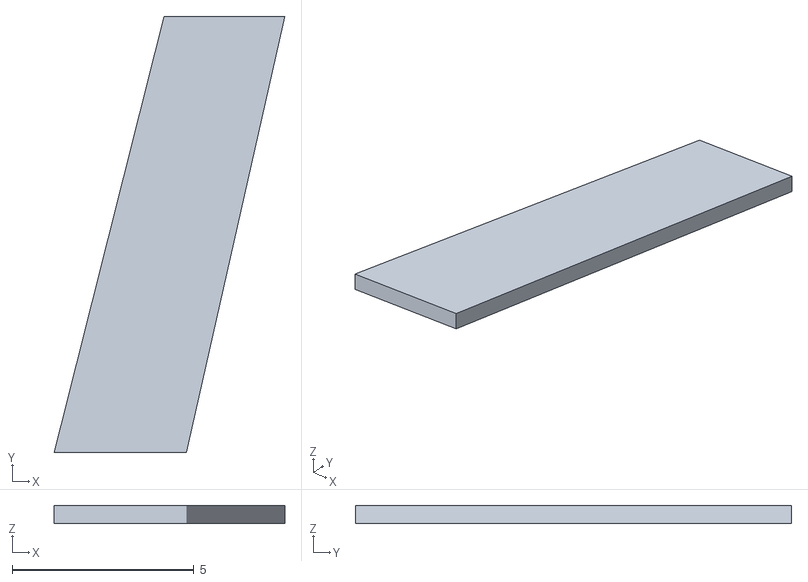
[picture p68: CAD file, 2026-01-24]
Prints/Individual/Flips/Assembled - X - Char_Prev_Top_3-1.STL
6.35 x 12.0 x 0.5
