ikrasmus/Bestaboard/Prints/Individual/Flips/Assembled - X - Char_Prev_Top_2-1.STL

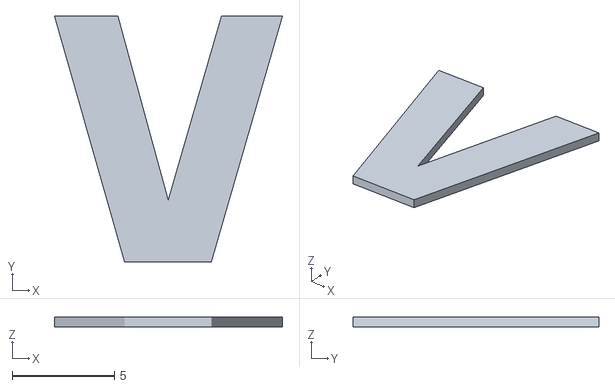
[picture p69: CAD file, 2026-01-24]
Prints/Individual/Flips/Assembled - X - Char_Prev_Top_2-1.STL
11.1 x 12.0 x 0.5
