ikrasmus/Bestaboard/Prints/Individual/Flips/Assembled - D - Char_Top-1.STL

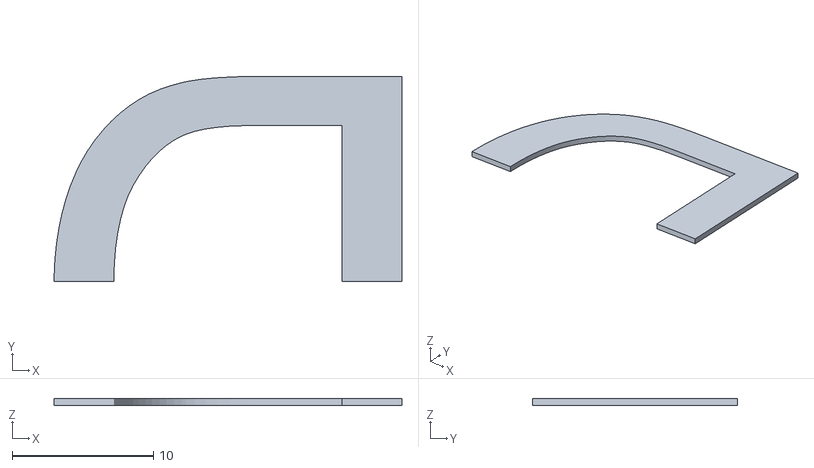
[picture p70: CAD file, 2026-01-24]
Prints/Individual/Flips/Assembled - D - Char_Top-1.STL
24.6 x 14.5 x 0.5
