ikrasmus/Bestaboard/Prints/Individual/Flips/Assembled - D - Char_Prev_Top-1.STL

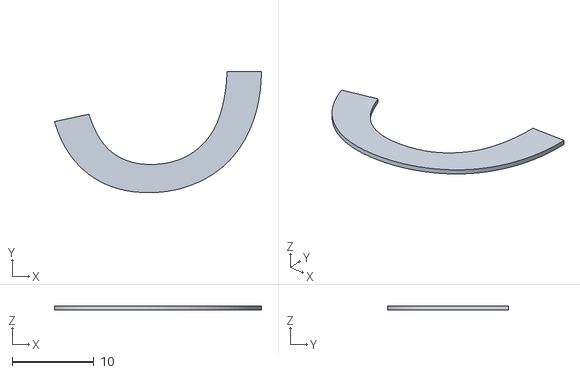
[picture p71: CAD file, 2026-01-24]
Prints/Individual/Flips/Assembled - D - Char_Prev_Top-1.STL
25.4 x 14.9 x 0.5
