ikrasmus/Bestaboard/Prints/Individual/Flips/Assembled - B - Char_Bottom-1.STL

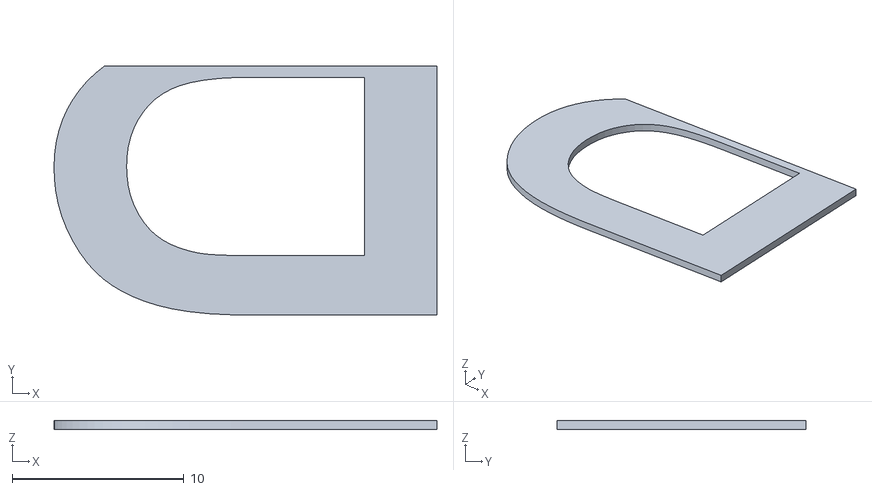
[picture p72: CAD file, 2026-01-24]
Prints/Individual/Flips/Assembled - B - Char_Bottom-1.STL
22.3 x 14.5 x 0.5
