ikrasmus/Bestaboard/Prints/Individual/Flips/Assembled - P - Body_Top_2-1.STL

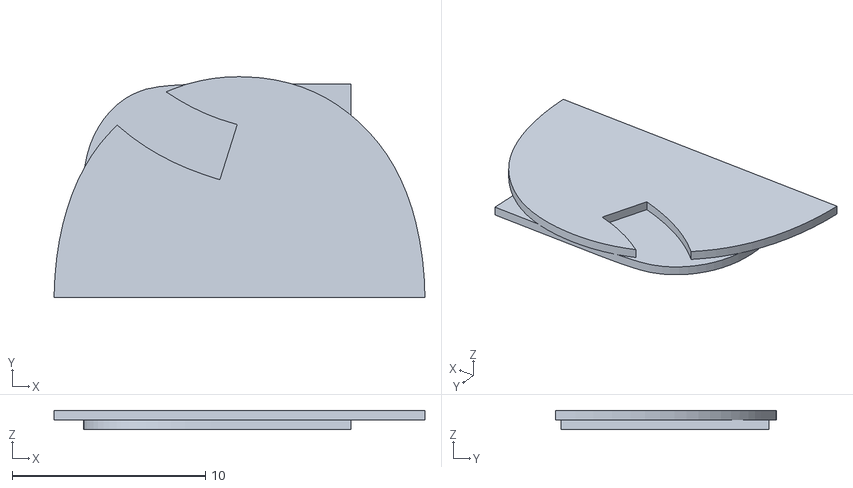
[picture p73: CAD file, 2026-01-24]
Prints/Individual/Flips/Assembled - P - Body_Top_2-1.STL
19.2 x 11.4 x 1.00
