ikrasmus/Bestaboard/Prints/Individual/Flips/Assembled - H - Char_Top-1.STL

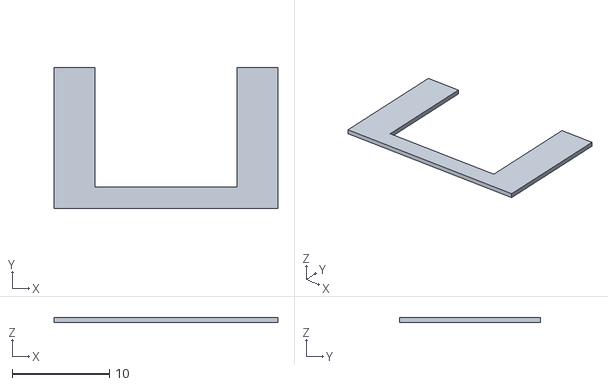
[picture p74: CAD file, 2026-01-24]
Prints/Individual/Flips/Assembled - H - Char_Top-1.STL
23.1 x 14.5 x 0.5
