ikrasmus/Bestaboard/Prints/Individual/Flips/Assembled - P - Body_Top_1-1.STL

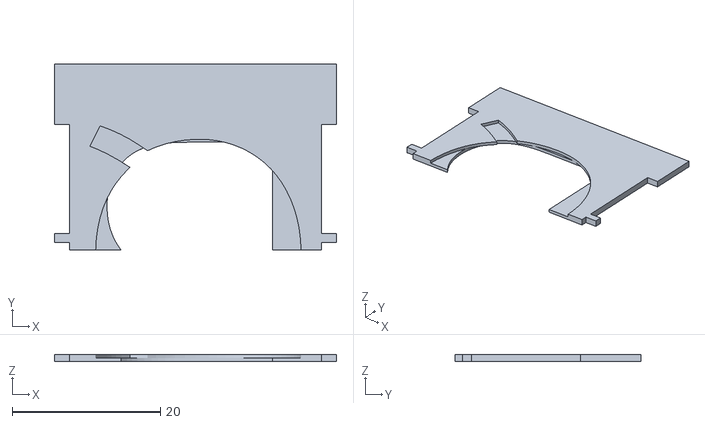
[picture p75: CAD file, 2026-01-24]
Prints/Individual/Flips/Assembled - P - Body_Top_1-1.STL
38.0 x 25.0 x 1.00
