ikrasmus/Bestaboard/Prints/Individual/Flips/Assembled - F - Char_Next_Bot-1.STL

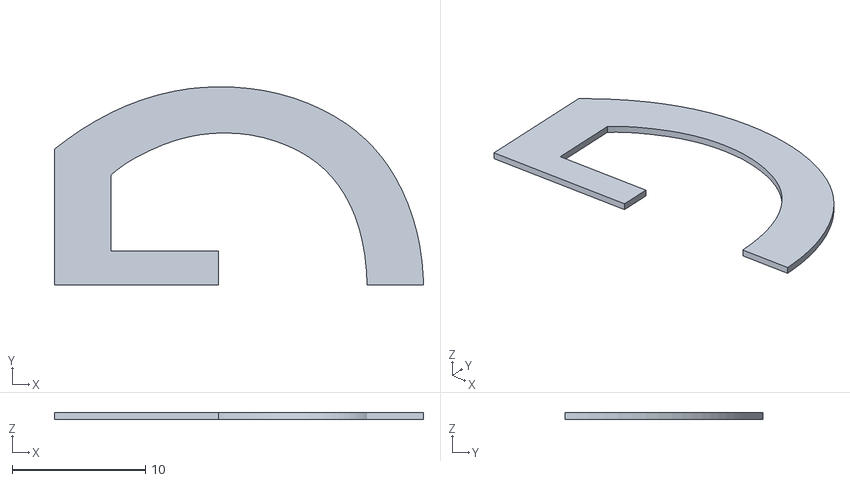
[picture p76: CAD file, 2026-01-24]
Prints/Individual/Flips/Assembled - F - Char_Next_Bot-1.STL
27.7 x 14.9 x 0.5
