ikrasmus/Bestaboard/Prints/Individual/Flips/Assembled - R - Char_Bot-1.STL

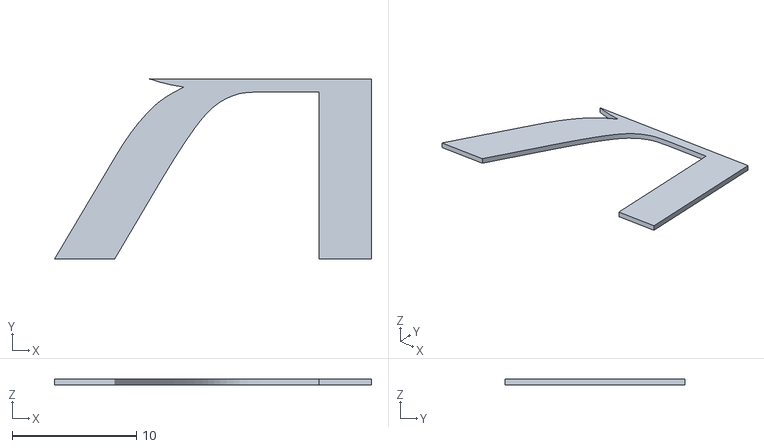
[picture p77: CAD file, 2026-01-24]
Prints/Individual/Flips/Assembled - R - Char_Bot-1.STL
25.5 x 14.5 x 0.5
