ikrasmus/Bestaboard/Prints/Individual/Flips/Assembled - J - Char_Next_Bot_1-1.STL

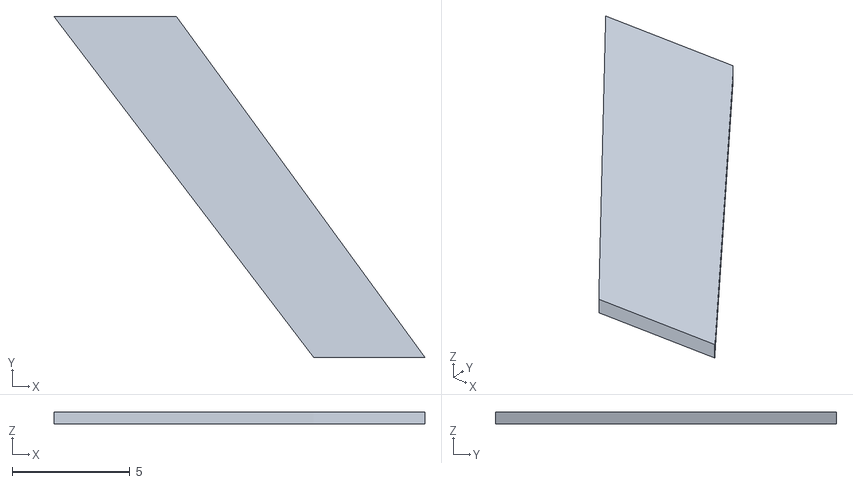
[picture p78: CAD file, 2026-01-24]
Prints/Individual/Flips/Assembled - J - Char_Next_Bot_1-1.STL
15.8 x 14.5 x 0.5
