ikrasmus/Bestaboard/Prints/Individual/Flips/Assembled - B - Char_Top-1.STL

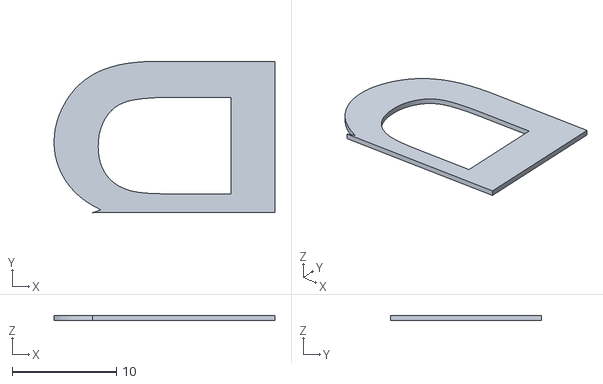
[picture p79: CAD file, 2026-01-24]
Prints/Individual/Flips/Assembled - B - Char_Top-1.STL
21.2 x 14.5 x 0.5
