ikrasmus/Bestaboard/Solidworks/Flips/Question - Assembled.SLDASM

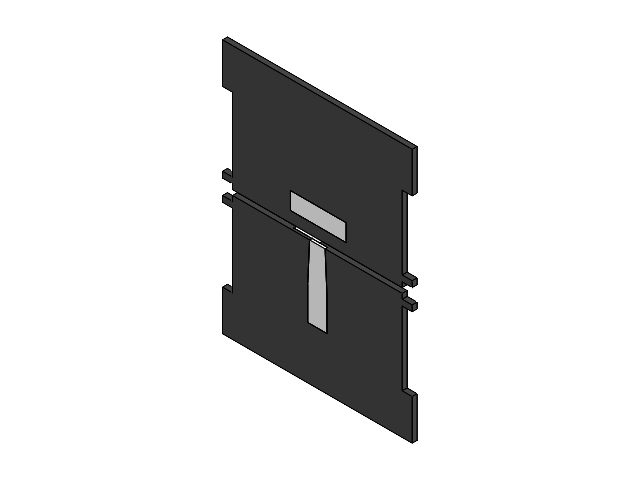
[picture p80: CAD file, 2026-02-08]
Solidworks/Flips/Question - Assembled.SLDASM
Question - Body_Bottom
Question - Body_Top
Question - Char_Bottom_1
Question - Char_Bottom_2
Question - Char_Next_Bottom
Question - Char_Prev_Top
Question - Char_Top
