ikrasmus/Bestaboard/Solidworks/Flips/Home - Assembled.SLDASM

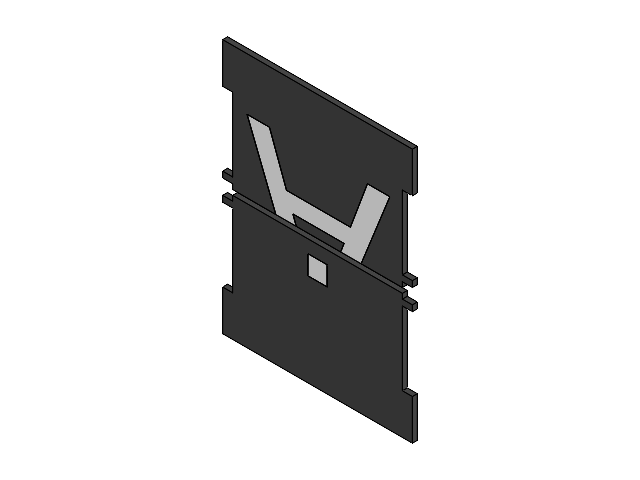
[picture p81: CAD file, 2026-02-08]
Solidworks/Flips/Home - Assembled.SLDASM
Home - Body_Bottom
Home - Body_Top
Home - Char_Next_Bottom
Home - Char_Prev_Top
