ikrasmus/Bestaboard/Solidworks/Frame & Drum/Drum - Assembled.SLDASM

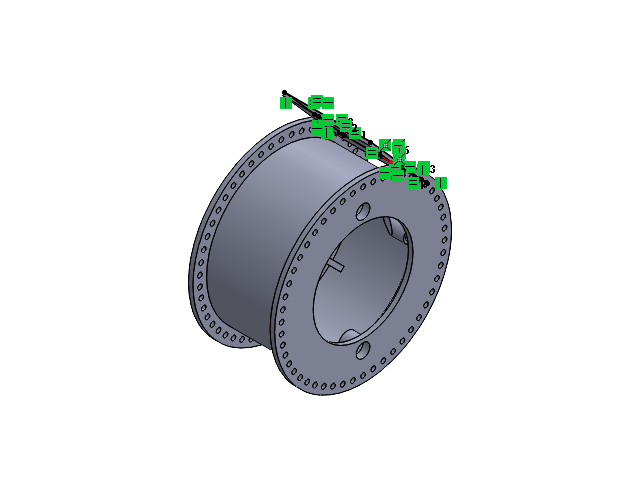
[picture p82: CAD file, 2026-01-24]
Solidworks/Frame & Drum/Drum - Assembled.SLDASM
Flip
Drum
Drum - End
