ikrasmus/Bestaboard/Solidworks/Flips/9 - Assembled.SLDASM

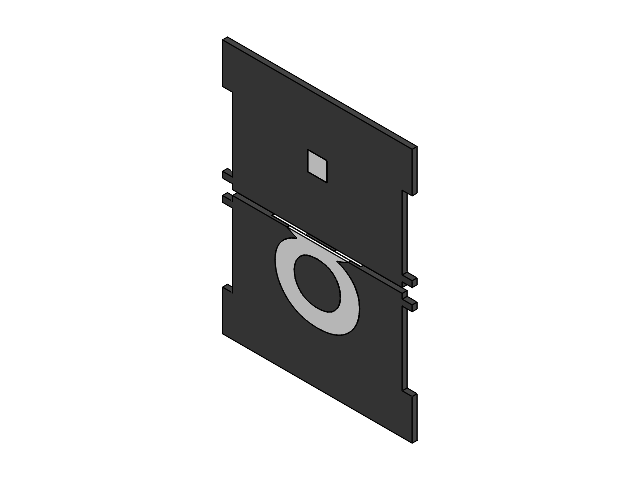
[picture p83: CAD file, 2026-02-08]
Solidworks/Flips/9 - Assembled.SLDASM
9 - Body_Bottom_1
9 - Body_Bottom_2
9 - Body_Top
9 - Char_Bottom
9 - Char_Next_Bottom
9 - Char_Prev_Top
9 - Char_Top
