ikrasmus/Bestaboard/Solidworks/Flips/Asterisk - Assembled.SLDASM

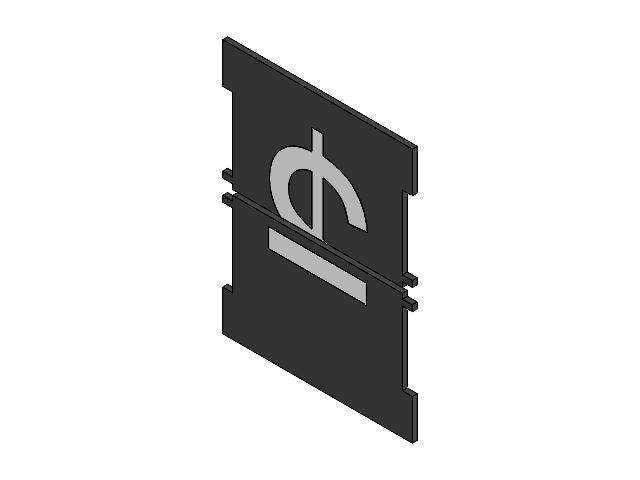
[picture p84: CAD file, 2026-02-08]
Solidworks/Flips/Asterisk - Assembled.SLDASM
Asterisk - Body_Bottom
Asterisk - Body_Top
Asterisk - Char_Next_Bottom
Asterisk - Char_Prev_Top
Asterisk - Char_Top
