ikrasmus/Bestaboard/Solidworks/Flips/7 - Assembled.SLDASM

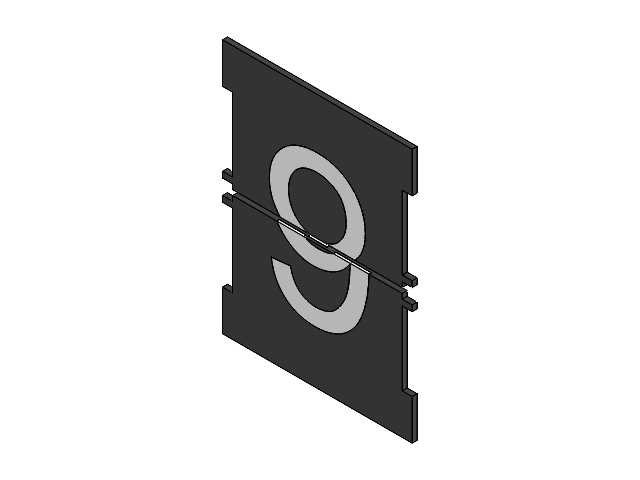
[picture p85: CAD file, 2026-02-08]
Solidworks/Flips/7 - Assembled.SLDASM
7 - Body_Bottom
7 - Body_Top
7 - Char_Bottom
7 - Char_Next_Bottom
7 - Char_Prev_Top
7 - Char_Top
