ikrasmus/Bestaboard/Solidworks/Flips/5 - Assembled.SLDASM

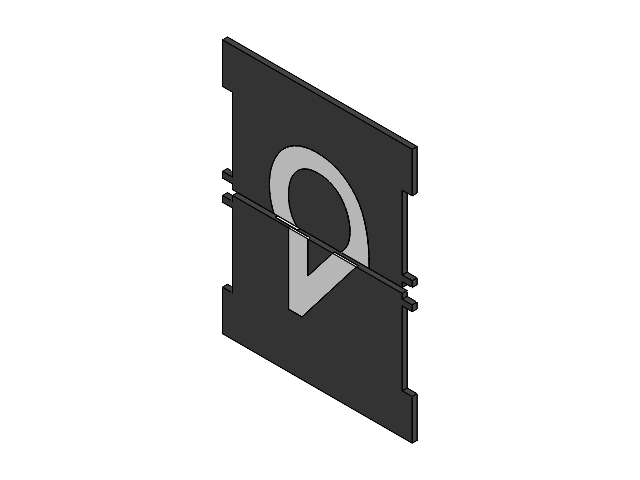
[picture p86: CAD file, 2026-02-08]
Solidworks/Flips/5 - Assembled.SLDASM
5 - Body_Bottom
5 - Body_Top
5 - Char_Bottom
5 - Char_Next_Bottom
5 - Char_Prev_Top
5 - Char_Top
