ikrasmus/Bestaboard/Solidworks/Flips/Colon - Assembled.SLDASM

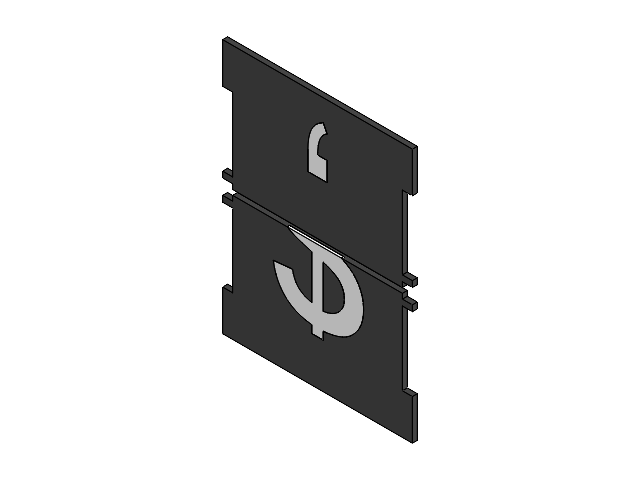
[picture p87: CAD file, 2026-02-08]
Solidworks/Flips/Colon - Assembled.SLDASM
Colon - Body_Bottom
Colon - Body_Top
Colon - Char_Bottom
Colon - Char_Next_Bottom
Colon - Char_Prev_Top
Colon - Char_Top
