ikrasmus/Bestaboard/Solidworks/Flips/+ - Assembled.SLDASM

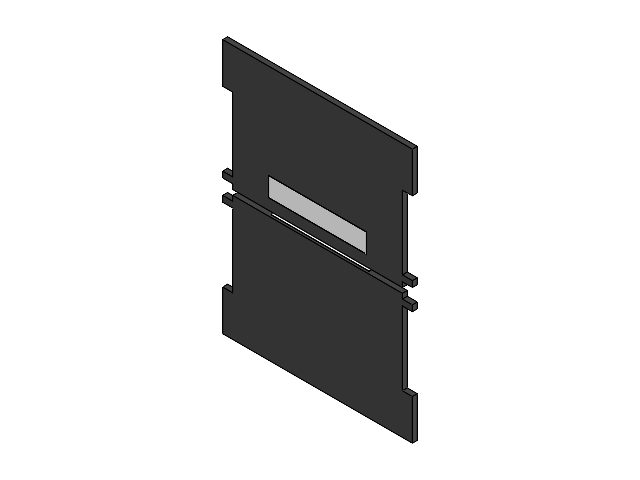
[picture p88: CAD file, 2026-02-08]
Solidworks/Flips/+ - Assembled.SLDASM
+ - Body_Bottom
+ - Body_Top
+ - Char_Bottom
+ - Char_Prev_Top
+ - Char_Top
