ikrasmus/Bestaboard/Solidworks/Flips/1 - Assembled.SLDASM

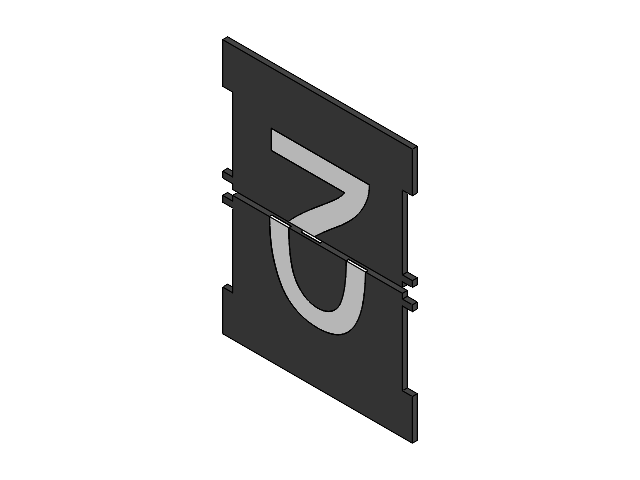
[picture p89: CAD file, 2026-01-27]
Solidworks/Flips/1 - Assembled.SLDASM
1 - Body_Bottom
1 - Body_Top
1 - Char_Bottom
1 - Char_Next_Bottom
1 - Char_Prev_Top
1 - Char_Top
