ikrasmus/Bestaboard/Solidworks/Flips/Z - Assembled.SLDASM

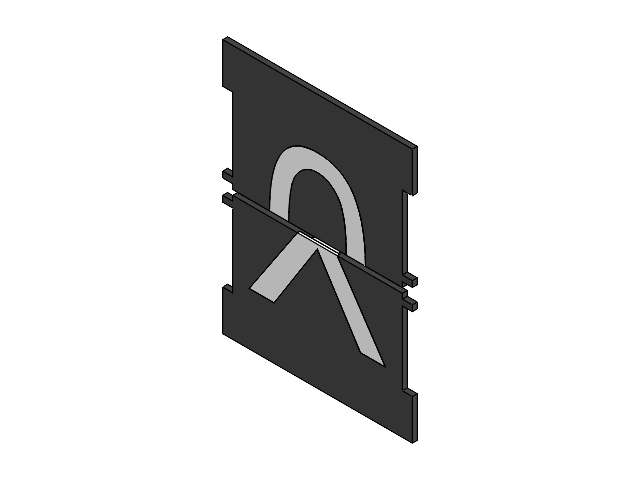
[picture p90: CAD file, 2026-01-27]
Solidworks/Flips/Z - Assembled.SLDASM
Z - Body_Bottom
Z - Body_Top
Z - Char_Bottom
Z - Char_Next_Bottom
Z - Char_Prev_Top
Z - Char_Top
