ikrasmus/Bestaboard/Solidworks/Flips/3 - Assembled.SLDASM

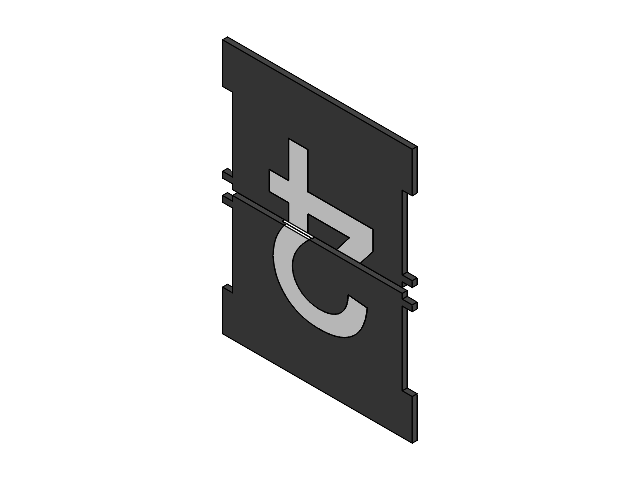
[picture p91: CAD file, 2026-01-27]
Solidworks/Flips/3 - Assembled.SLDASM
3 - Body_Bottom
3 - Body_Top
3 - Char_Next_Top
3 - Char_Prev_Bottom
3 - Char_Top
3 - Char_Bottom
