ikrasmus/Bestaboard/Solidworks/Flips/P - Assembled.SLDASM

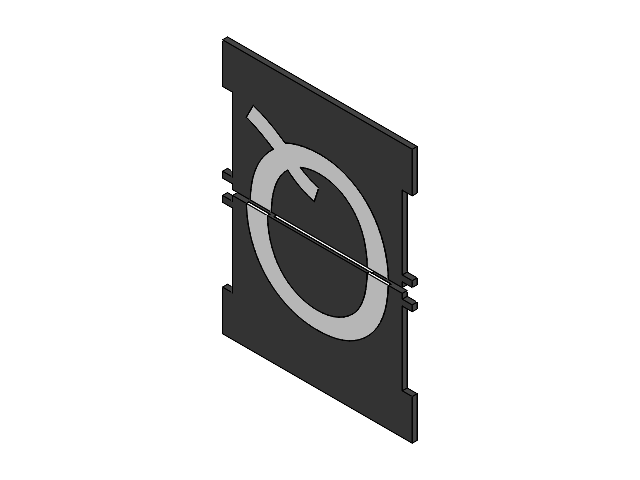
[picture p92: CAD file, 2026-01-24]
Solidworks/Flips/P - Assembled.SLDASM
P - Body_Bottom
P - Body_Top_1
P - Body_Top_2
P - Char_Bot
P - Char_Next_Bot
P - Char_Prev_Top
P - Char_Top
