ikrasmus/Bestaboard/Solidworks/Flips/B - Assembled.SLDASM

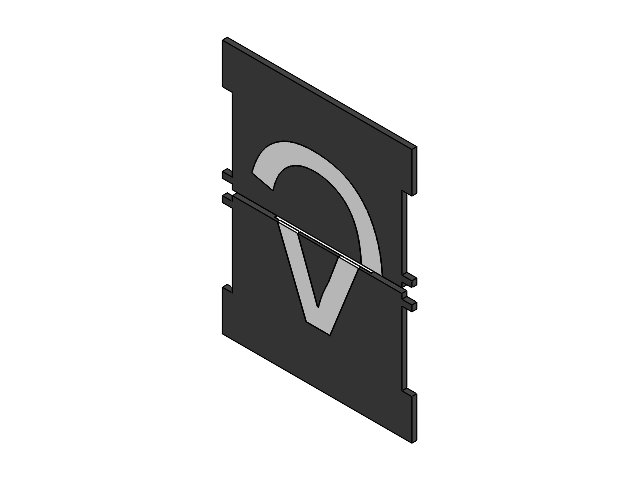
[picture p93: CAD file, 2026-01-24]
Solidworks/Flips/B - Assembled.SLDASM
B - Body_Bottom
B - Body_Top
B - Char_Bottom
B - Char_Next_Bottom
B - Char_Prev_Top
B - Char_Top
