ikrasmus/Bestaboard/Solidworks/Flips/V - Assembled.SLDASM

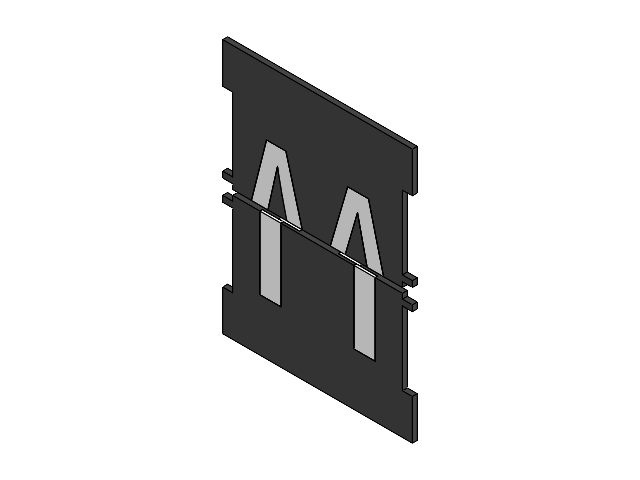
[picture p94: CAD file, 2026-01-24]
Solidworks/Flips/V - Assembled.SLDASM
V - Body_Bottom
V - Body_Top
V - Char_Bottom
V - Char_Next_Bot_1
V - Char_Prev_Bot_2
V - Char_Prev_Top_1
V - Char_Prev_Top_2
V - Char_Top_1
V - Char_Top_2
