ikrasmus/Bestaboard/(list of files, cad)

Other CAD files:
Solidworks/Tools/Tool - Drum_Assembly.SLDPRT
Prints/Individual/Frame & Drum/Frame - Main.STL
Solidworks/Frame & Drum/Drum - Main.SLDPRT
Prints/Individual/Flips/Assembled - + - Body_Top-1.STL
Prints/Individual/Flips/Assembled - Colon - Body_Bottom-1.STL
Prints/Individual/Flips/Assembled - Home - Body_Bottom-1.STL
Prints/Individual/Flips/Assembled - Question - Body_Top-1.STL
Prints/Individual/Flips/Assembled - + - Body_Bottom-1.STL
Prints/Individual/Flips/Assembled - Home - Body_Top-1.STL
Prints/Individual/Flips/Assembled - Colon - Char_Top-1.STL
Prints/Individual/Flips/Assembled - Colon - Body_Top-1.STL
Prints/Individual/Flips/Assembled - + - Char_Prev_Top-1.STL
Prints/Individual/Flips/Assembled - Asterisk - Body_Top-1.STL
Prints/Individual/Flips/Assembled - Colon - Char_Bottom-1.STL
Prints/Individual/Flips/Assembled - Asterisk - Body_Bottom-1.STL
Prints/Individual/Flips/Assembled - Question - Char_Bottom_2-1.STL
Prints/Individual/Flips/Assembled - Home - Char_Prev_Top-1.STL
Prints/Individual/Flips/Assembled - Colon - Char_Next_Bottom-1.STL
Prints/Individual/Flips/Assembled - 1 - Body_Bottom-1.STL
Prints/Individual/Flips/Assembled - 9 - Body_Top-1.STL
Prints/Individual/Flips/Assembled - 7 - Body_Top-1.STL
Prints/Individual/Flips/Assembled - 5 - Body_Top-1.STL
Prints/Individual/Flips/Assembled - 1 - Body_Top-1.STL
Prints/Individual/Flips/Assembled - Z - Body_Top-1.STL
Prints/Individual/Flips/Assembled - Z - Body_Bottom-1.STL
Prints/Individual/Flips/Assembled - 7 - Body_Bottom-1.STL
Prints/Individual/Flips/Assembled - 9 - Body_Bottom_1-1.STL
Prints/Individual/Flips/Assembled - 5 - Char_Top-1.STL
Prints/Individual/Flips/Assembled - 1 - Char_Prev_Top-1.STL
Prints/Individual/Flips/Assembled - 3 - Body_Top-1.STL
Prints/Individual/Flips/Assembled - 9 - Char_Next_Bottom-1.STL
Prints/Individual/Flips/Assembled - N - Body_Bottom-1.STL
Prints/Individual/Flips/Assembled - T - Body_Top-1.STL
Prints/Individual/Flips/Assembled - F - Body_Bottom-1.STL
Prints/Individual/Flips/Assembled - N - Body_Top-1.STL
Prints/Individual/Flips/Assembled - X - Body_Top-1.STL
Prints/Individual/Flips/Assembled - N - Char_Bot_1-1.STL
Prints/Individual/Flips/Assembled - V - Char_Prev_Top_1-1.STL
Prints/Individual/Flips/Assembled - H - Body_Top-1.STL
Prints/Individual/Flips/Assembled - H - Body_Bottom-1.STL
Prints/Individual/Flips/Assembled - R - Body_Bottom-1.STL
Prints/Individual/Flips/Assembled - V - Char_Prev_Top_2-1.STL
Prints/Individual/Flips/Assembled - T - Char_Bottom-1.STL
Prints/Individual/Flips/Assembled - J - Body_Bottom-1.STL
Prints/Individual/Flips/Assembled - P - Body_Bottom-1.STL
Prints/Individual/Flips/Assembled - D - Body_Bottom-1.STL
Prints/Individual/Flips/Assembled - N - Char_Top_2-1.STL
Prints/Individual/Flips/Assembled - P - Char_Prev_Top-1.STL
Prints/Individual/Flips/Assembled - H - Char_Next_Bot-1.STL
Prints/Individual/Flips/Assembled - J - Char_Top-1.STL
Prints/Individual/Flips/Assembled - L - Char_Next_Bot_3-1.STL
Prints/Individual/Flips/Assembled - D - Char_Bottom-1.STL
Prints/Individual/Flips/Assembled - V - Char_Top_1-1.STL
Prints/Individual/Flips/Assembled - R - Char_Prev_Top-1.STL
Prints/Individual/Flips/Assembled - L - Body_Top-1.STL
Prints/Individual/Flips/Assembled - D - Body_Top-1.STL
Prints/Individual/Flips/Assembled - X - Body_Bottom-1.STL
Prints/Individual/Flips/Assembled - F - Body_Top-1.STL
Prints/Individual/Flips/Assembled - V - Body_Top-1.STL
Prints/Individual/Flips/Assembled - , - Body_Bottom-1.STL
Prints/Individual/Flips/Assembled - , - Body_Top-1.STL
Prints/Individual/Flips/Assembled - B - Body_Bottom-1.STL
Prints/Individual/Flips/Assembled - B - Body_Top-1.STL
Prints/Individual/Flips/Assembled - F - Char_Bottom-1.STL
Prints/Individual/Flips/Assembled - F - Char_Prev_Top-1.STL
Prints/Individual/Flips/Assembled - J - Body_Top-1.STL
Prints/Individual/Flips/Assembled - J - Char_Next_Bot_2-1.STL
Prints/Individual/Flips/Assembled - L - Body_Bottom-1.STL
Prints/Individual/Flips/Assembled - L - Char_Next_Bot_1-1.STL
Prints/Individual/Flips/Assembled - L - Char_Next_Bot_2-1.STL
Prints/Individual/Flips/Assembled - L - Char_Top-1.STL
Prints/Individual/Flips/Assembled - N - Char_Bot_2-1.STL
Prints/Individual/Flips/Assembled - N - Char_Prev_Top_1-1.STL
Prints/Individual/Flips/Assembled - N - Char_Prev_Top_2-1.STL
Prints/Individual/Flips/Assembled - R - Body_Top-1.STL
Prints/Individual/Flips/Assembled - R - Char_Next_Bot-1.STL
Prints/Individual/Flips/Assembled - T - Body_Bottom-1.STL
Prints/Individual/Flips/Assembled - T - Char_Prev_Top-1.STL
Prints/Individual/Flips/Assembled - V - Body_Bottom-1.STL
Prints/Individual/Flips/Assembled - V - Char_Bottom-1.STL
Prints/Individual/Flips/Assembled - V - Char_Next_Bot_1-1.STL
Prints/Individual/Flips/Assembled - X - Char_Bottom-1.STL
Prints/Individual/Flips/Assembled - X - Char_Prev_Top_1-1.STL
Prints/Individual/Frame & Drum/Drum - End.STL
Prints/Individual/Frame & Drum/Frame - Flip_Holder - 16.5mm.STL
Prints/Individual/Frame & Drum/Frame - Flip_Holder - 16.75mm.STL
Prints/Individual/Frame & Drum/Frame - Flip_Holder - 17mm.STL
Prints/Individual/Frame & Drum/Frame - Wire_Holder.STL
Prints/Individual/PCB/PCB - Binder.STL
Prints/Individual/PCB/PCB - Spacer.3mf
Prints/Plates/Drum.3mf
Prints/Plates/Flips.3mf
Prints/Plates/Frame.3mf
Prints/Plates/PCB.3mf
Solidworks/Flips/+ - Body_Bottom.SLDPRT
Solidworks/Flips/+ - Body_Top.SLDPRT
Solidworks/Flips/+ - Char_Bottom.SLDPRT
Solidworks/Flips/+ - Char_Prev_Top.SLDPRT
Solidworks/Flips/+ - Char_Top.SLDPRT
Solidworks/Flips/, - Assembled.SLDASM
Solidworks/Flips/, - Body_Bottom.SLDPRT
Solidworks/Flips/, - Body_Top.SLDPRT
Solidworks/Flips/, - Char_Next_Bottom.SLDPRT
Solidworks/Flips/, - Front_Extrude.SLDPRT
Solidworks/Flips/, - Prev_Extrude.SLDPRT
Solidworks/Flips/1 - Body_Bottom.SLDPRT
Solidworks/Flips/1 - Body_Top.SLDPRT
Solidworks/Flips/1 - Char_Bottom.SLDPRT
Solidworks/Flips/1 - Char_Next_Bottom.SLDPRT
Solidworks/Flips/1 - Char_Prev_Top.SLDPRT
Solidworks/Flips/1 - Char_Top.SLDPRT
Solidworks/Flips/3 - Body_Bottom.SLDPRT
Solidworks/Flips/3 - Body_Top.SLDPRT
Solidworks/Flips/3 - Char_Bottom.SLDPRT
Solidworks/Flips/3 - Char_Next_Top.SLDPRT
Solidworks/Flips/3 - Char_Prev_Bottom.SLDPRT
Solidworks/Flips/3 - Char_Top.SLDPRT
Solidworks/Flips/5 - Body_Bottom.SLDPRT
Solidworks/Flips/5 - Body_Top.SLDPRT
Solidworks/Flips/5 - Char_Bottom.SLDPRT
Solidworks/Flips/5 - Char_Next_Bottom.SLDPRT
Solidworks/Flips/5 - Char_Prev_Top.SLDPRT
Solidworks/Flips/5 - Char_Top.SLDPRT
Solidworks/Flips/7 - Body_Bottom.SLDPRT
Solidworks/Flips/7 - Body_Top.SLDPRT
Solidworks/Flips/7 - Char_Bottom.SLDPRT
Solidworks/Flips/7 - Char_Next_Bottom.SLDPRT
Solidworks/Flips/7 - Char_Prev_Top.SLDPRT
Solidworks/Flips/7 - Char_Top.SLDPRT
Solidworks/Flips/9 - Body_Bottom_1.SLDPRT
Solidworks/Flips/9 - Body_Bottom_2.SLDPRT
Solidworks/Flips/9 - Body_Top.SLDPRT
Solidworks/Flips/9 - Char_Bottom.SLDPRT
Solidworks/Flips/9 - Char_Next_Bottom.SLDPRT
Solidworks/Flips/9 - Char_Prev_Top.SLDPRT
Solidworks/Flips/9 - Char_Top.SLDPRT
Solidworks/Flips/Asterisk - Body_Bottom.SLDPRT
Solidworks/Flips/Asterisk - Body_Top.SLDPRT
Solidworks/Flips/Asterisk - Char_Next_Bottom.SLDPRT
Solidworks/Flips/Asterisk - Char_Prev_Top.SLDPRT
Solidworks/Flips/Asterisk - Char_Top.SLDPRT
Solidworks/Flips/B - Body_Bottom.SLDPRT
Solidworks/Flips/B - Body_Top.SLDPRT
Solidworks/Flips/B - Char_Bottom.SLDPRT
Solidworks/Flips/B - Char_Next_Bottom.SLDPRT
Solidworks/Flips/B - Char_Prev_Top.SLDPRT
Solidworks/Flips/B - Char_Top.SLDPRT
Solidworks/Flips/Colon - Body_Bottom.SLDPRT
Solidworks/Flips/Colon - Body_Top.SLDPRT
Solidworks/Flips/Colon - Char_Bottom.SLDPRT
Solidworks/Flips/Colon - Char_Next_Bottom.SLDPRT
Solidworks/Flips/Colon - Char_Prev_Top.SLDPRT
Solidworks/Flips/Colon - Char_Top.SLDPRT
Solidworks/Flips/Creator - +.SLDPRT
Solidworks/Flips/Creator - ,.SLDPRT
Solidworks/Flips/Creator - 1.SLDPRT
Solidworks/Flips/Creator - 3.SLDPRT
Solidworks/Flips/Creator - 5.SLDPRT
Solidworks/Flips/Creator - 7.SLDPRT
Solidworks/Flips/Creator - 9.SLDPRT
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
