ikrasmus/Bestaboard/Schematic/Bestaboard/Bestaboard.pdf

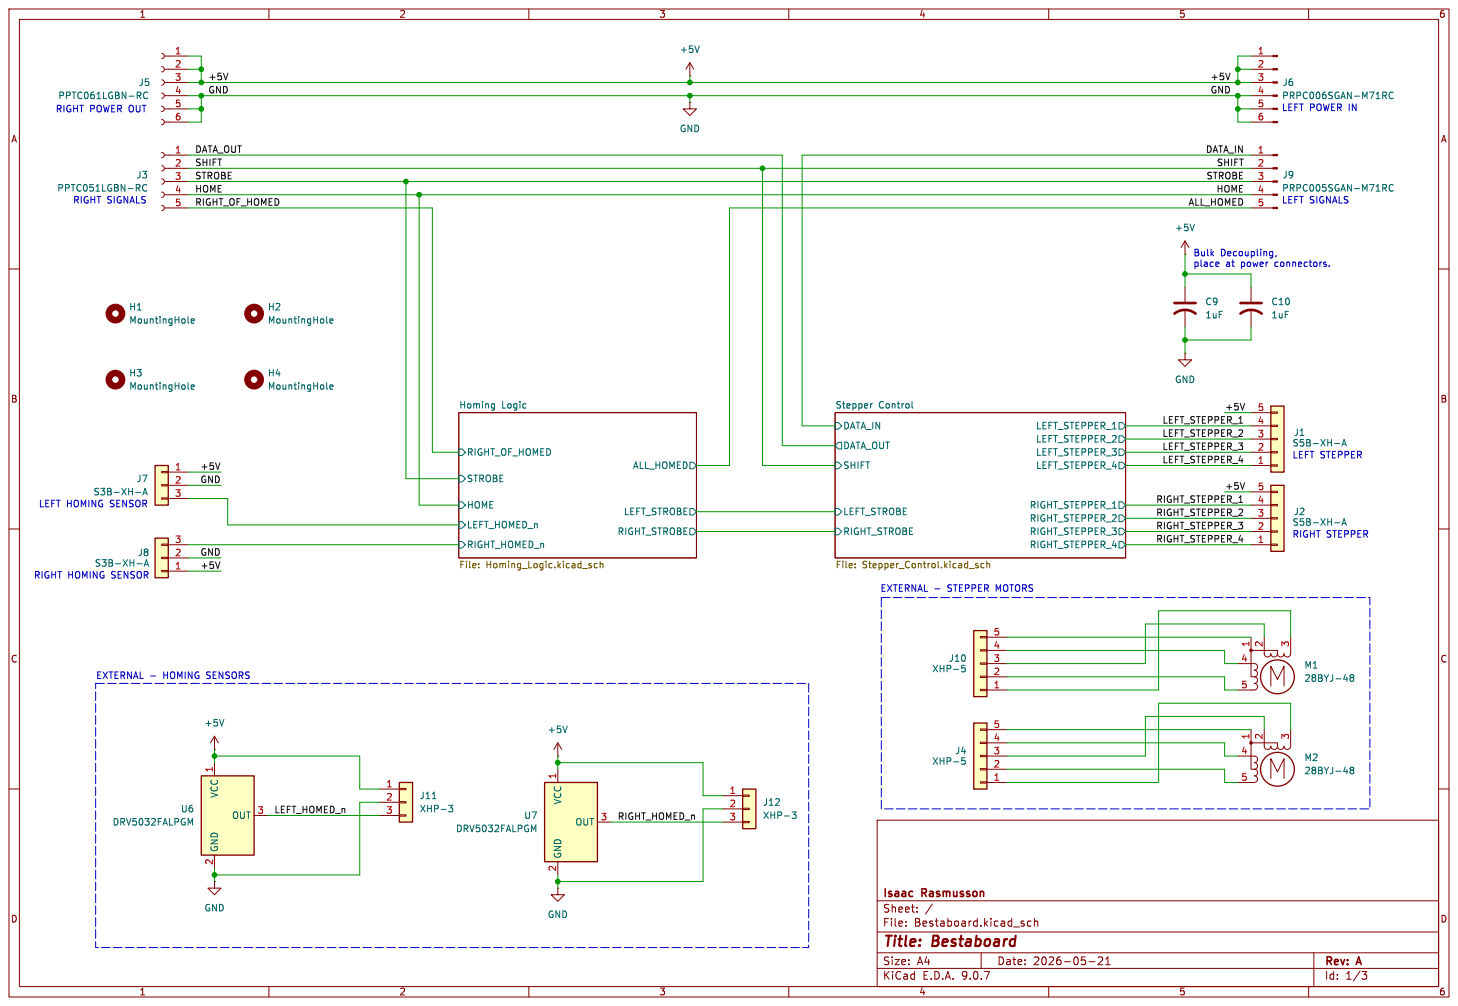
[picture p95: page 1]

RIGHT POWER OUT RIGHT SIGNALS

place at power connectors. RIGHT HOMING SENSOR

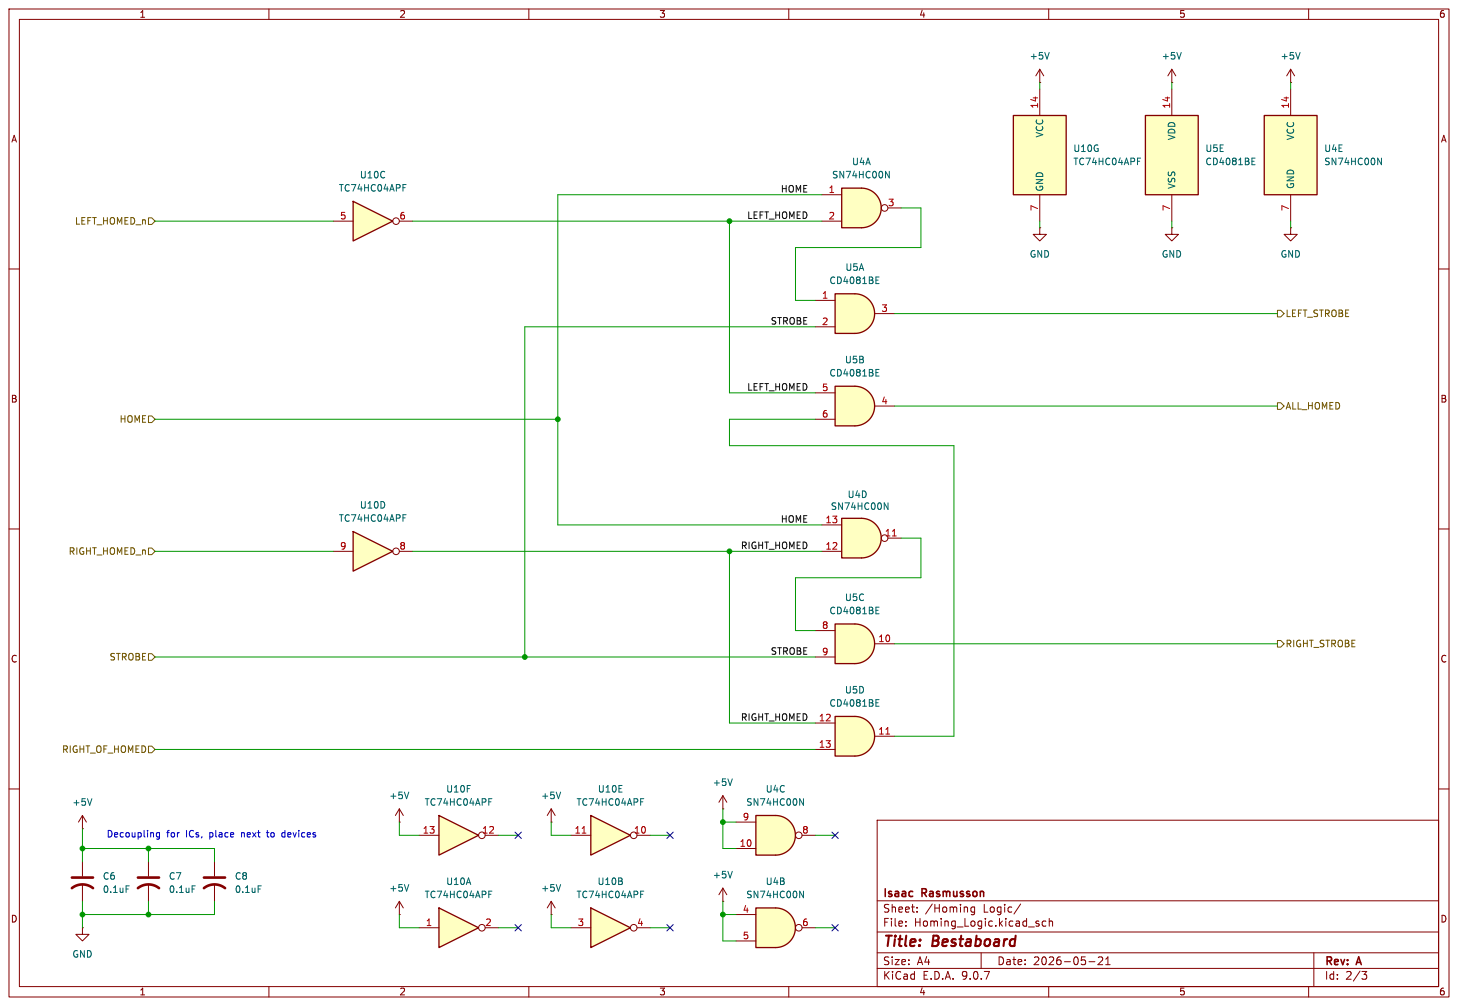
[picture p96: page 2]

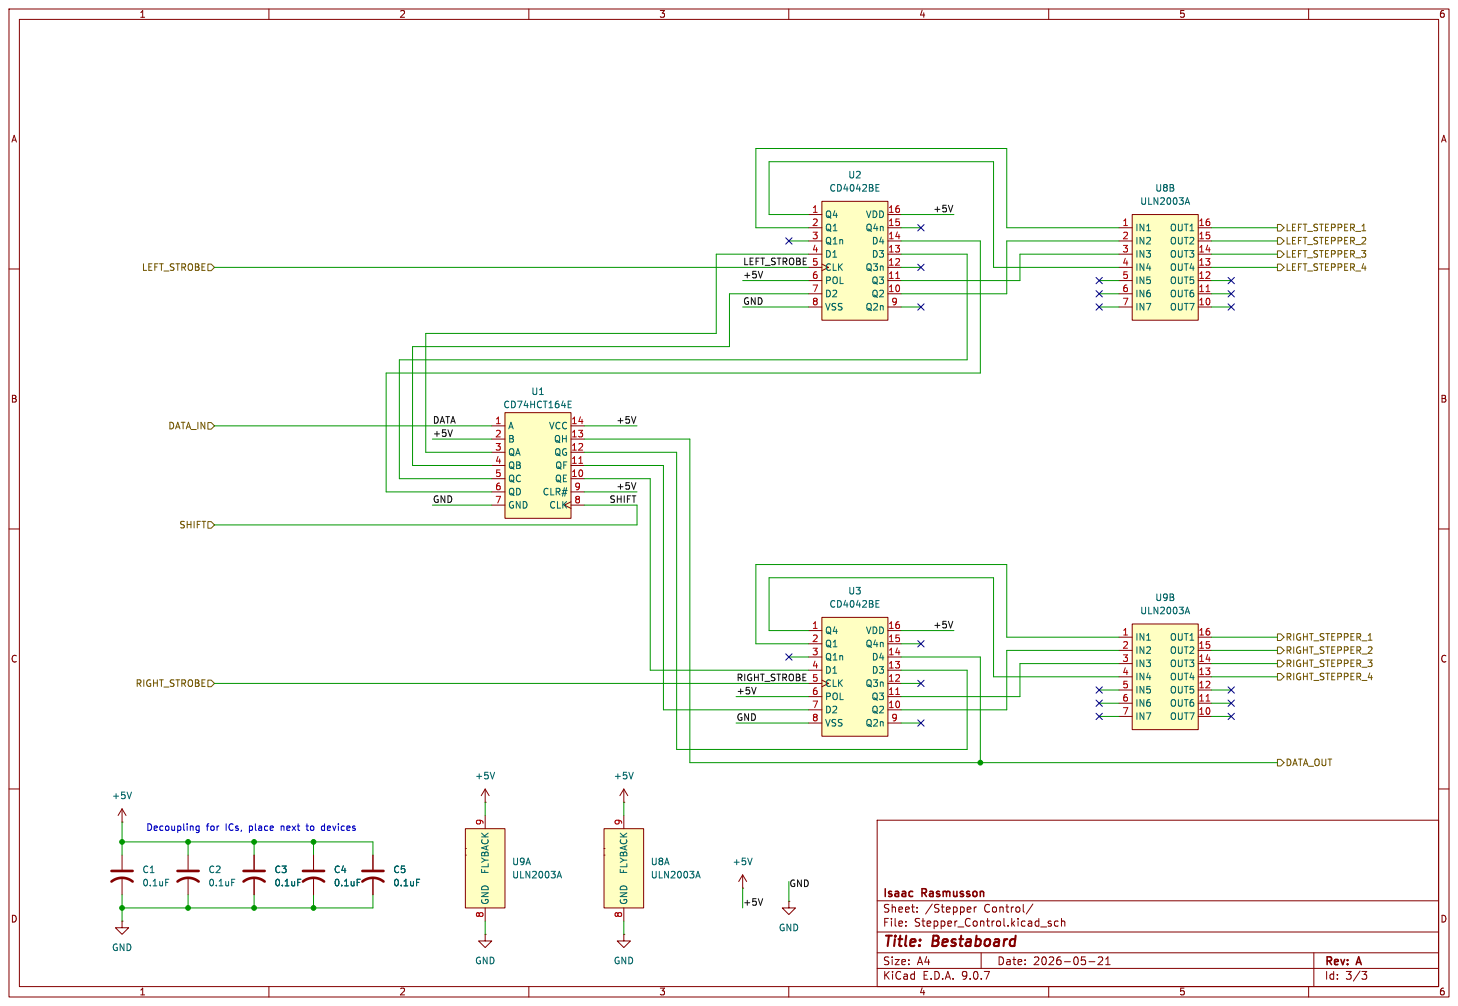
[picture p97: page 3]
