ikrasmus/Bestaboard/(commit log)

2026-01-25 3D: Magnet Sensor and Alignment
    Added magnet sensor cutout to frame. Change drum from 50 flip locations to 48, added magnet and alignment hole.
    [Drum - End.SLDPRT, Drum - End.STL, Drum - Main.SLDPRT, Drum - Main.STL, Frame - Main.SLDPRT, Frame - Main.STL]
2026-01-27 3D - Modeling Progress
    Added new characters, updated sensor cutout and alignment hole for drum.
    [1 - Assembled.SLDASM, 1 - Body_Bottom.SLDPRT, 1 - Body_Top.SLDPRT, 1 - Char_Bottom.SLDPRT, 1 - Char_Next_Bottom.SLDPRT, 1 - Char_Prev_Top.SLDPRT, 1 - Char_Top.SLDPRT, 3 - Assembled.SLDASM]
2026-02-08 Completed Chars + Drum Update
    [+ - Assembled.SLDASM, + - Body_Bottom.SLDPRT, + - Body_Top.SLDPRT, + - Char_Bottom.SLDPRT, + - Char_Prev_Top.SLDPRT, + - Char_Top.SLDPRT, , - Assembled.SLDASM, , - Body_Bottom.SLDPRT]
2026-03-22 Diagnostics Update
    Included diagnostics and preparation for homing to charachter mode.
2026-04-02 Board, Schematic, and Firmware Updates
    Created board, updated schematic to include additional decoupling and connector changes, changed firmware to be more troubleshooting friendly.
2026-04-08 3D Model and Code Update
    Improved sensor wire routing, and changed firmware to run on Arduino Nano. Also added pushbutton inputs into interrupt routine.
    [Frame - Main.SLDPRT, Frame - Main.STL, Frame - Wire_Holder.SLDPRT, Frame - Wire_Holder.STL]
2026-04-14 Updated Schematic and PCB
    Updated schematic and PCB to change NAND gate that doesn't require pull up, and fixed data out signal.
    Started creating Bambu Lab printing plates.
    [Drum - End.3mf, Drum - Main.3mf, Drum.3mf, Flips - 1.3mf]
2026-04-14 Moved local copy schematic into repo.
    [Bestaboard.kicad_pcb, Bestaboard.kicad_sch, Homing_Logic.kicad_sch, Servo_Control.kicad_sch, Stepper_Control.kicad_sch, untitled.kicad_sch]
2026-04-16 Prints, Schematic, PCB, Code Update
    Prints - Created print plates for flips, drum and frame, updated frame to have mounting holes on the bottom.
    PCB/Schematic - Changed to 14 pin NAND chip, updated parameters.
    Code - Changed code to alternate between homing and character rotation.
    [Bestaboard.kicad_pcb, Bestaboard.kicad_sch, Flips - 1.3mf, Frame - Main.SLDPRT, Frame - Main.STL, Homing_Logic.kicad_sch, Stepper_Control.kicad_sch]
2026-04-18 Code, Plates & Drum
    Cleaned up code, now transitions between both modes successfully.
    Created plates for printing.
    Frame - Moved wire hole and added mounting holes.
    Drum - Started increasing hole size and adjust model to copensate.
    [Drum - End.3mf, Drum - End.SLDPRT, Drum - End.STL, Drum - Main -enlarge.STL, Drum - Main.3mf, Drum - Main.SLDPRT, Drum.3mf, Frame - Main.3mf]
2026-04-19 PCB Board Ordered vA
    Board and schematic ordered to match this repo.
    Continued work on 3D model to increase size of drum.
    [Bestaboard-B_Cu.gbl, Bestaboard-B_Mask.gbs, Bestaboard-B_Paste.gbp, Bestaboard-B_SilkScreen.gbo, Bestaboard-Edge_Cuts.gm1, Bestaboard-F_Cu.gtl, Bestaboard-F_Mask.gts, Bestaboard-F_Paste.gtp]
2026-04-25 Drum Size Increase
    Increased drum size and all affected models to allow two frames to sit side by size.
    [Bestaboard.csv, Drum - Main.SLDPRT, Drum - Main.STL, Drum.3mf, Flips - 1.3mf, Frame - Flip_Holder.SLDPRT, Frame - Flip_Holder.STL, Frame - Main.3mf]
2026-04-26 Code & New Prints
    Created new prints for slightly longer flip holders 16.75mm and 17mm.
    Fixed bug on A character targeting, when switching to homing the stepper was already detecting home and not rotating. Added a guaranteed one character rotation to homing. This bring the stepper past the homing sensor and allows homing to take place.
    [Frame - Flip_Holder - 16.5mm.STL, Frame - Flip_Holder - 16.75mm.STL, Frame - Flip_Holder - 17mm.SLDPRT, Frame - Flip_Holder - 17mm.STL, Frame - Flip_Holder - 18mm.SLDPRT, Frame - Flip_Holder.SLDPRT, Frame - Flip_Holder.STL, Frame.3mf]
2026-05-03 PCB Assembly Items & Code
    Created code to switch between two demo words YALE & AIDC, cleaned up parts of the code, changed some constants to defines and added prefixes to variables.
    Created looping variable counter "word_loop" to track the amount of times the main loop has gone through, used for changing first pass homing logic and switching the word that is up next.
    [Frame - Flip_Holder.SLDPRT, PCB - Binder.SLDPRT, PCB - Binder.STL, PCB - Spacer.3mf, PCB - Spacer.SLDPRT, PCB.3mf]
2026-05-05 Code Update
    Added flip offsets to character targets and increased speed.
    [Flips.3mf, PCB - Binder.STL, PCB - Spacer.3mf]
2026-05-21 Output BOM and updated parts list
    [Bestaboard.csv, Bestaboard.kicad_sch, Homing_Logic.kicad_sch, Stepper_Control.kicad_sch]
2026-05-25 Schematic PDF & Schematic
    Updated title block to include date and name. Created PDF of scheamtic.
    [Bestaboard.kicad_sch, Homing_Logic.kicad_sch, Stepper_Control.kicad_sch]
2026-09-20 Folder Clean Up
    Removed old files and moved others into folders.
    [Bestaboard.kicad_pcb, Bestaboard.kicad_sch, Homing_Logic.kicad_sch, PCB - Binder.SLDPRT, PCB - Spacer.SLDPRT, Servo_Control.kicad_sch, untitled.kicad_sch]
2026-09-20 Updated README
    Moved Images section and shrunk the PCB_vA image down.
